dwkennedy/ballooning/README.md

# ballooning
all-in-one ballooning accessory (variometer, balloon cut-down, let down reel, tracking)
