dwkennedy/ballooning/documentation/README.md

[current version found here](https://docs.google.com/document/d/1-JqKBCpE__L-fvbFsnMLXefRrbQfZvNeuHzBmR8RMiw/edit?usp=sharing)
