dwkennedy/ballooning/hardware/schematic sketch.png

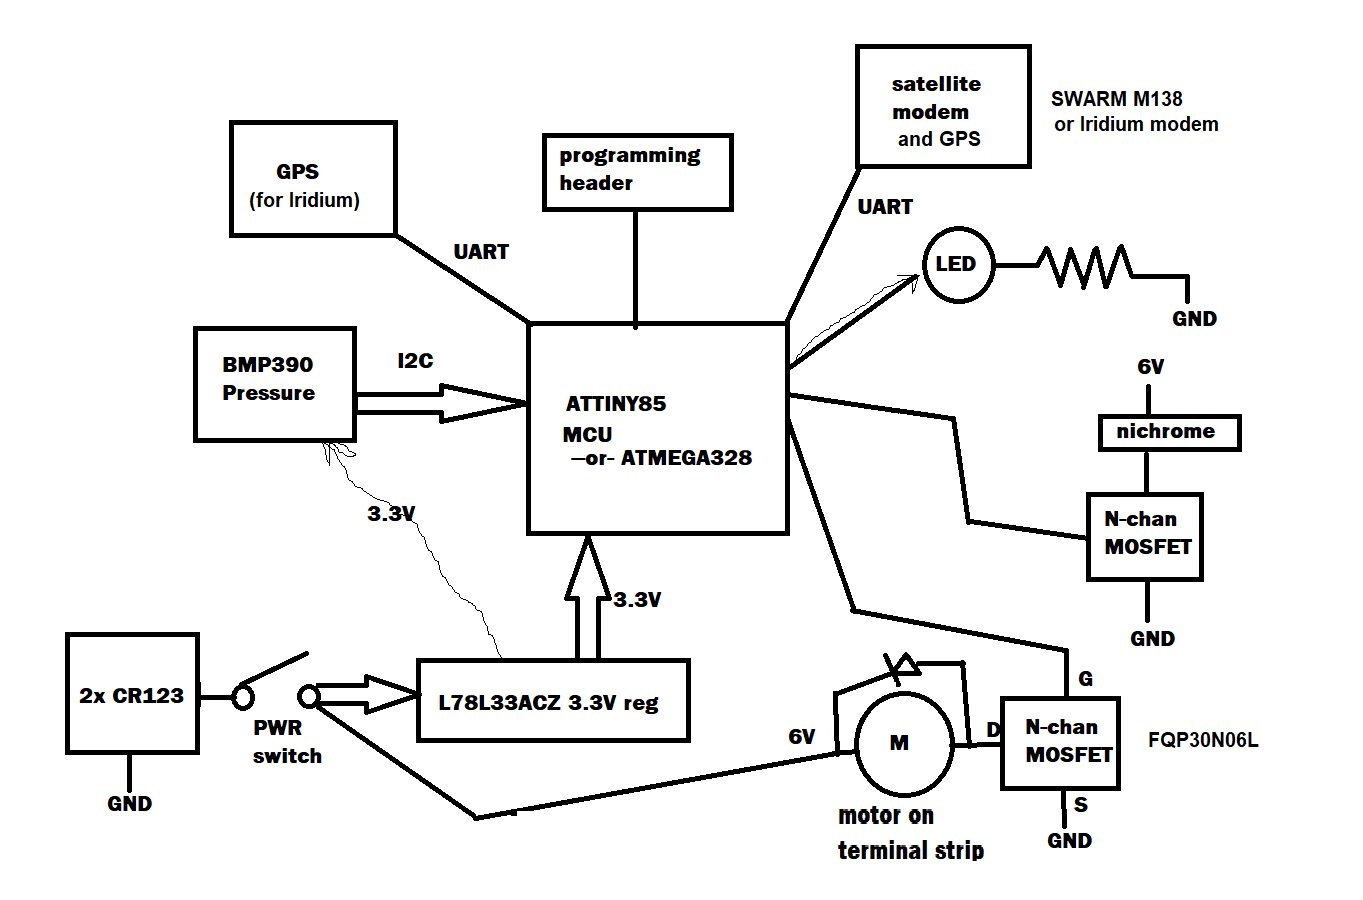
hardware/schematic sketch.png
