dwkennedy/ballooning/hardware/wombat_crop.jpg

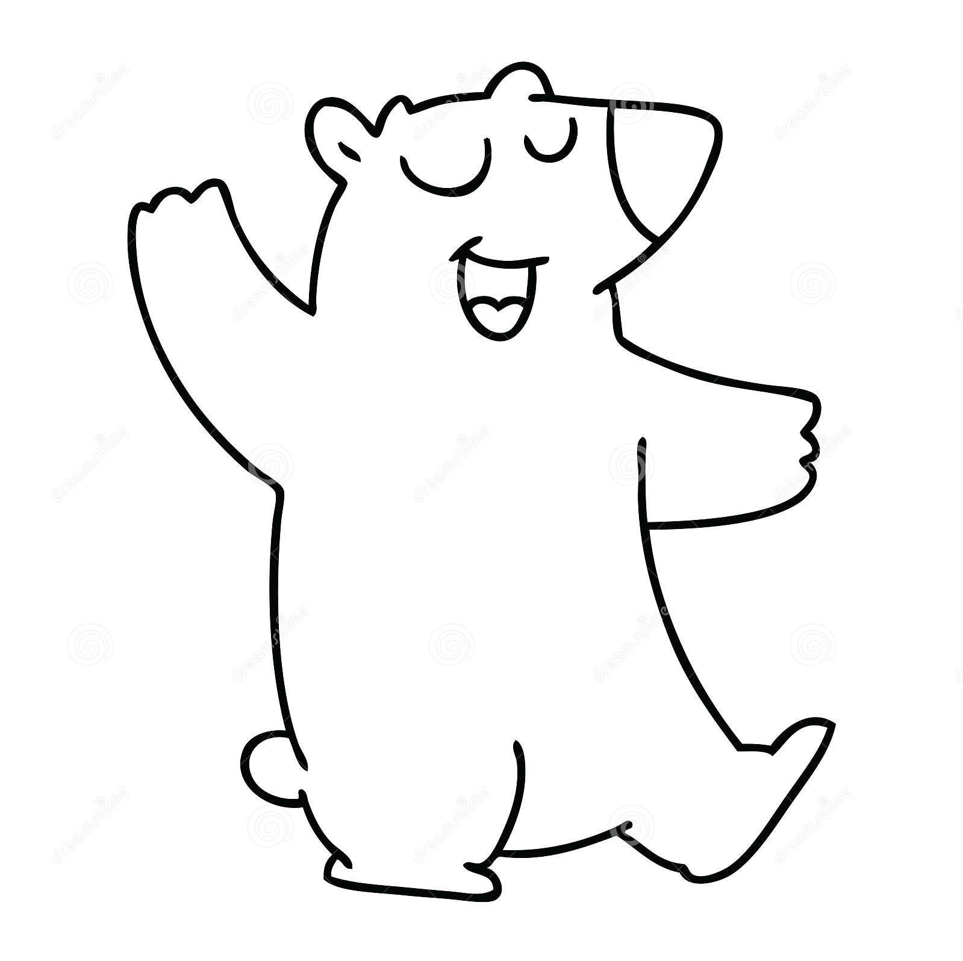
hardware/wombat_crop.jpg
