dwkennedy/ballooning/hardware/wombat_flip.jpg

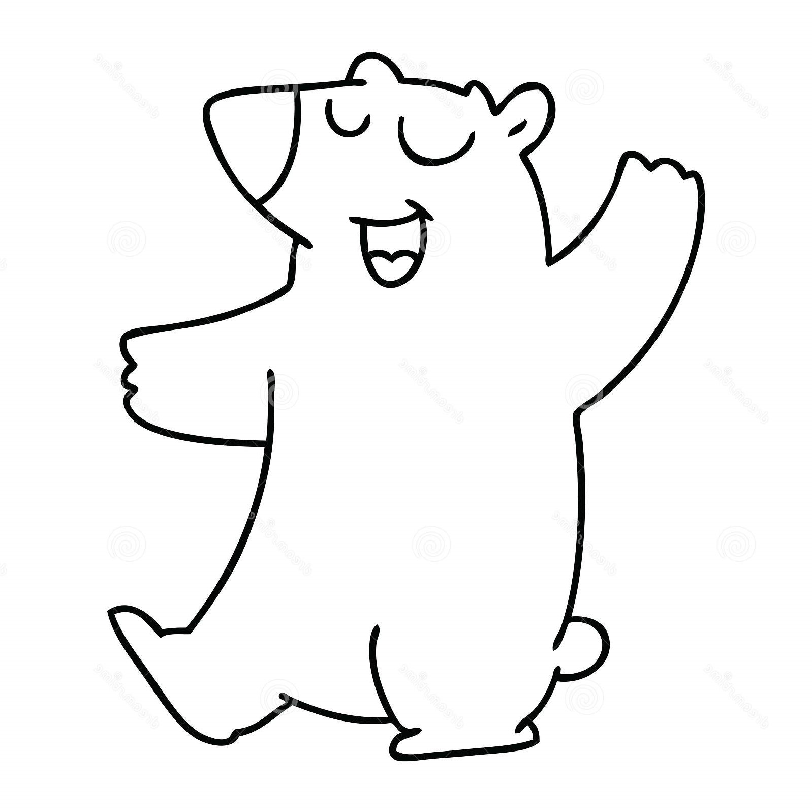
hardware/wombat_flip.jpg
