dwkennedy/ballooning/webapi/web application plumbing.png

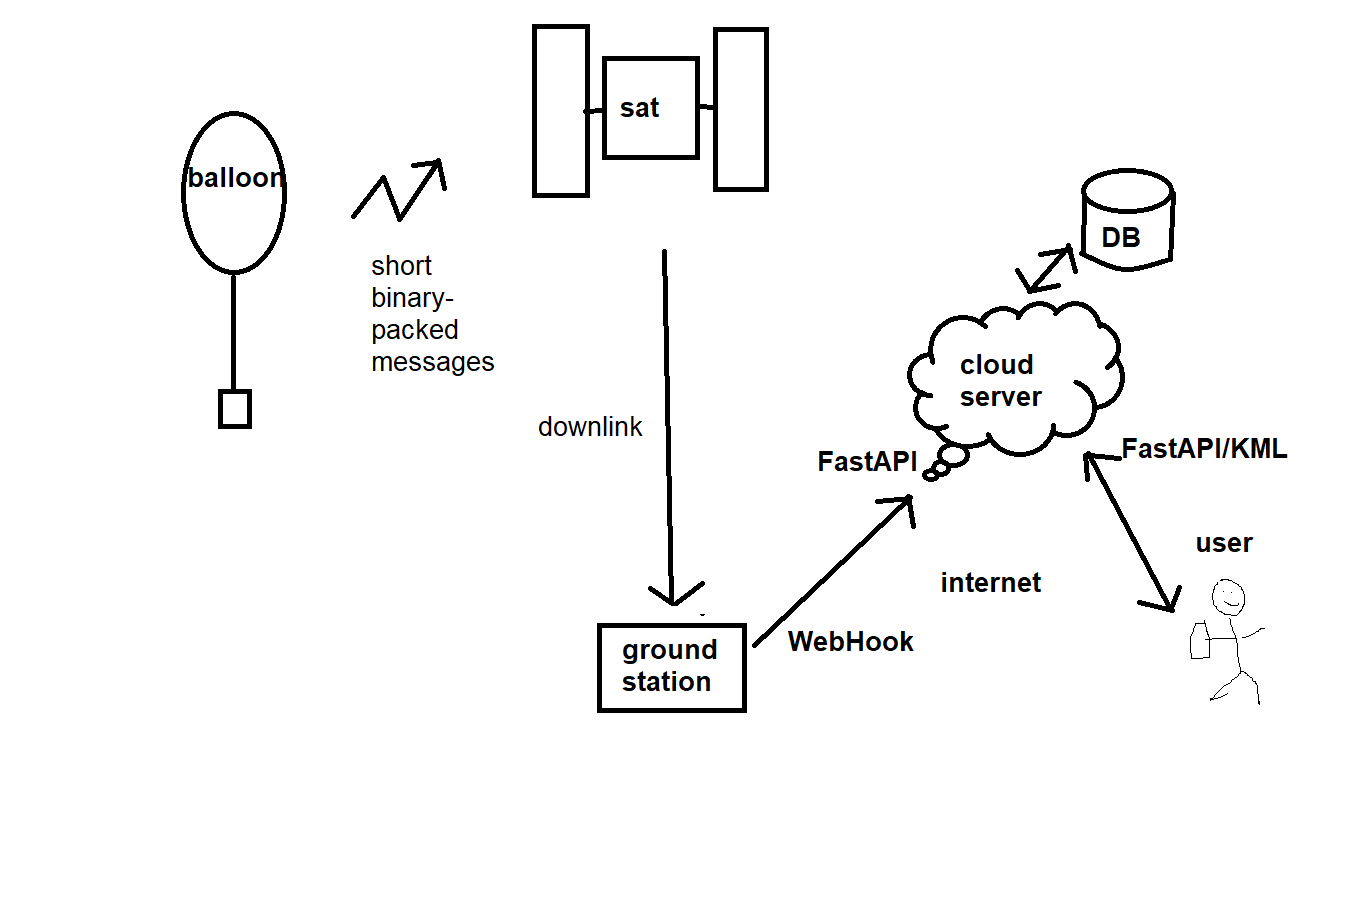
webapi/web application plumbing.png
