dwkennedy/ballooning/hardware/cut down control board BOM annotated.xlsx

Id | Designator | Package | Quantity | Designation | Supplier and ref | Column1 | _1
1 | R3,R2,R1 | R_Axial_DIN0204_L3.6mm_D1.6mm_P7.62mm_Horizontal | 3 | 10K | https://www.mouser.com/ProductDetail/YAGEO/CFR-12JT-52-10K | 0.1
2 | BT2,BT1,BT3 | BatteryHolder_Keystone_1051_1xCR123A | 3 | Battery_Cell | https://www.mouser.com/ProductDetail/Keystone-Electronics/1051?qs=wOxb8XianXhV6wGCGUD6gA%3D%3D | 1.84
3 | R8,R9 | R_Axial_DIN0204_L3.6mm_D1.6mm_P7.62mm_Horizontal | 2 | 1K | https://www.mouser.com/ProductDetail/YAGEO/CFR-12JT-52-1K?qs=uYSUDLr2H%2FJr7fImvVXADQ%3D%3D | 0.1
4 | J12 | PinHeader_2x03_P2.54mm_Vertical | 1 | Analog In | https://www.mouser.com/ProductDetail/Amphenol-FCI/10129381-906002BLF?qs=DXv0QSHKF4zSKXKyBbBVMw%3D%3D | 0.132
5 | ,,,,, |  | 6
6 | J13 | JST_XH_B2B-XH-A_1x02_P2.50mm_Vertical | 1 | EXT BATT | https://www.mouser.com/ProductDetail/Adafruit/4423?qs=xZ%2FP%252Ba9zWqZe%2FzQxvLxuOw%3D%3D | 0
7 | Q1,Q2 | TO-220-3_Horizontal_TabDown | 2 | FQP30N06L | https://www.mouser.com/ProductDetail/onsemi-Fairchild/FQP30N06L?qs=%252Beu4QTTVkDqugBwFplJ%252Bug%3D%3D | 1.84
8 | D2 | LED_D3.0mm | 1 | GRN | https://www.mouser.com/ProductDetail/Kingbright/WP424GDT?qs=UaZr%2F4HME3YaIwbSYqFJhw%3D%3D | 0.186
9 | J10 | Molex_PicoBlade_53047-1010_1x10_P1.25mm_Vertical | 1 | SAT(10 picoblade) | https://www.mouser.com/ProductDetail/Molex/53047-1010?qs=dvxwXVM4mZUfJg3FKCXbvw%3D%3D | 0.436
10 | Y1 | Crystal_HC49-4H_Vertical | 1 | 16MHz | https://www.mouser.com/ProductDetail/Citizen-FineDevice/HC-49-U-S16000000ABJB?qs=byeeYqUIh0M5kN9OYTo1Hw%3D%3D | 0.425
11 | R4 | R_Axial_DIN0204_L3.6mm_D1.6mm_P7.62mm_Horizontal | 1 | 100K | https://www.mouser.com/ProductDetail/YAGEO/CFR-12JT-52-100K?qs=LdthLRB3J3RCxaN6X2Lk%2Fw%3D%3D | 0.052
12 | U6 | TO-220-3_Horizontal_TabDown | 1 | L7805 | https://www.mouser.com/ProductDetail/STMicroelectronics/L7805ABV-DG?qs=WHlX%252B%252B9%2FRwBQWEBhrAcOaw%3D%3D | 0.805
13 | C11 | C_Axial_L5.1mm_D3.1mm_P7.50mm_Horizontal | 1 | 1uF | https://www.mouser.com/ProductDetail/KEMET/C440C105M5U5TA7200?qs=yWO8DBVyAvj3irko5Wpznw%3D%3D | 0.22
14 | R7,R6 | R_Axial_DIN0204_L3.6mm_D1.6mm_P7.62mm_Horizontal | 2 | 130 ohm | https://www.mouser.com/ProductDetail/YAGEO/CFR-25JB-52-130R | 0.026
15 | C8,C9,C4,C10,C5 | C_Axial_L5.1mm_D3.1mm_P7.50mm_Horizontal | 5 | 0.1uF | https://www.mouser.com/ProductDetail/Vishay-BC-Components/A104M15X7RF5TAA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 | 0.096
16 | J5 | PinHeader_1x06_P2.54mm_Vertical | 1 | SAT(PIN HDR) | https://www.mouser.com/ProductDetail/Amphenol-FCI/10129378-906001BLF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 | 0.132
17 | J11 | SolderJumper-3_P1.3mm_Bridged12_RoundedPad1.0x1.5mm | 1 | VGPS SELECT |  | 0
18
19 | J2 | JST_XH_B2B-XH-A_1x02_P2.50mm_Vertical | 1 | MOTOR | https://www.mouser.com/ProductDetail/Adafruit/4423?qs=xZ%2FP%252Ba9zWqZe%2FzQxvLxuOw%3D%3D | 0
20 | C7,C6 | C_Axial_L5.1mm_D3.1mm_P7.50mm_Horizontal | 2 | 0.33uF | https://www.mouser.com/ProductDetail/KYOCERA-AVX/SA115E334MAR?qs=PESGGumn0y%252BfK25TKgqhUA%3D%3D | 0.237
21 | J3 | PinHeader_2x03_P2.54mm_Vertical | 1 | ISP | https://www.mouser.com/ProductDetail/Amphenol-FCI/10129381-906002BLF?qs=DXv0QSHKF4zSKXKyBbBVMw%3D%3D | 0.132
22 | J14 | JST_XH_B2B-XH-A_1x02_P2.50mm_Vertical | 1 | D8 I/O | https://www.mouser.com/ProductDetail/Amphenol-FCI/68004-200HLF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 | 0.055
23 | R5 | R_Axial_DIN0204_L3.6mm_D1.6mm_P7.62mm_Horizontal | 1 | 33K | https://www.mouser.com/ProductDetail/YAGEO/CFR-12JT-52-33K?qs=uYSUDLr2H%2FIH9PHmEu75xQ%3D%3D | 0.029
24 | U2 | NXP_LGA-8_3x5mm_P1.25mm_H1.1mm | 1 | MPL3115A2 | https://www.mouser.com/ProductDetail/?qs=6ddF3R%2F6EV%2Fx8daKoNGetQ%3D%3D | 5.61
25 | D1 | LED_D3.0mm | 1 | RED | https://www.mouser.com/ProductDetail/Kingbright/WP424EDT?qs=58z0TXQGVSTTc%2FTzBOpAyQ%3D%3D | 0.186
26 | U1 | DIP-28_W7.62mm | 1 | ATmega328-P | https://www.mouser.com/ProductDetail/Microchip-Technology-Atmel/ATMEGA328P-PU?qs=K8BHR703ZXguOQv3sKbWcg%3D%3D | 2.87
27 | C12 | CP_Radial_D5.0mm_P2.00mm | 1 | 10uF | https://www.mouser.com/ProductDetail/Panasonic/ECA-1VM100?qs=F80sRR%252BEZdBj42PTfvMN%2FQ%3D%3D | 0.116
28 | J1 | JST_XH_B2B-XH-A_1x02_P2.50mm_Vertical | 1 | CUTTER | https://www.mouser.com/ProductDetail/Adafruit/4423?qs=xZ%2FP%252Ba9zWqZe%2FzQxvLxuOw%3D%3D | 0
29 | J7 | PinHeader_1x06_P2.54mm_Vertical | 1 | DBG TTL | https://www.mouser.com/ProductDetail/Amphenol-FCI/10129378-906001BLF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 | 0.132
30 | J6 | PinHeader_1x04_P2.54mm_Vertical | 1 | GPS(PIN HDR) | https://www.mouser.com/ProductDetail/Harwin/M50-3530442 | 0.159
31 | J9 | JST_SH_BM06B-SRSS-TB_1x06-1MP_P1.00mm_Vertical | 1 | GPS(JST SH) | https://www.mouser.com/ProductDetail/SparkFun/GPS-00579?qs=WyAARYrbSnYMUvZSImI8yA%3D%3D | 1.95
32 | SW1 | JST_XH_B2B-XH-A_1x02_P2.50mm_Vertical | 1 | SW_SPST | https://www.mouser.com/ProductDetail/Adafruit/4423?qs=xZ%2FP%252Ba9zWqZe%2FzQxvLxuOw%3D%3D | 0
33 | C2,C1 | C_Disc_D4.7mm_W2.5mm_P5.00mm | 2 | 22pF | https://www.mouser.com/ProductDetail/KYOCERA-AVX/SA102A220JAR?qs=5furm%2FeQHzRJtFTgVl96eA%3D%3D | 0.145
34 | U5 | TO-92_Inline | 1 | L78L33_TO92 | https://www.mouser.com/ProductDetail/STMicroelectronics/L78L33ABZ-AP?qs=7IaIRco65plqHZGvVBuyKw%3D%3D | 0.386 | L78L33ABZ-AP
 |  |  |  |  | total: | 18.397
