dwkennedy/ballooning/solidworks/bulkhead assembly small.SLDASM

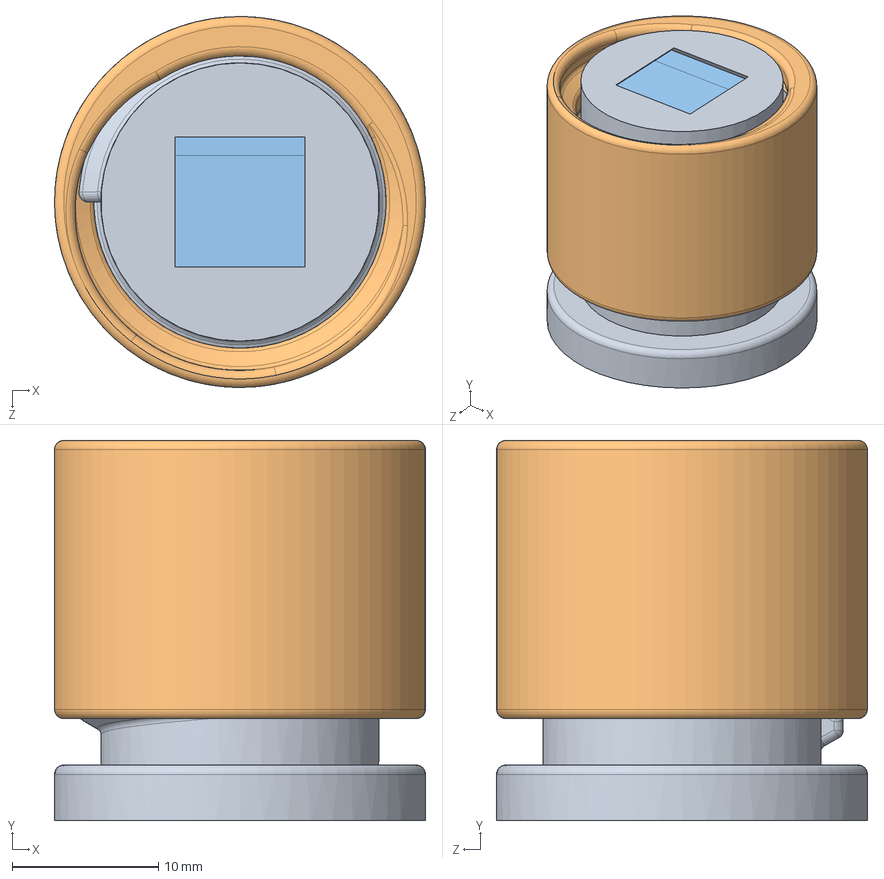
[picture p5: CAD file, 2023-01-06]
solidworks/bulkhead assembly small.SLDASM
25.4 x 26.0 x 25.4 mm
bulkhead body small
bulkhead nut small
93565K118_Super-Cushioning Polyethylene Foam Strip x 2
