dwkennedy/ballooning/solidworks/bulkhead assembly.SLDASM

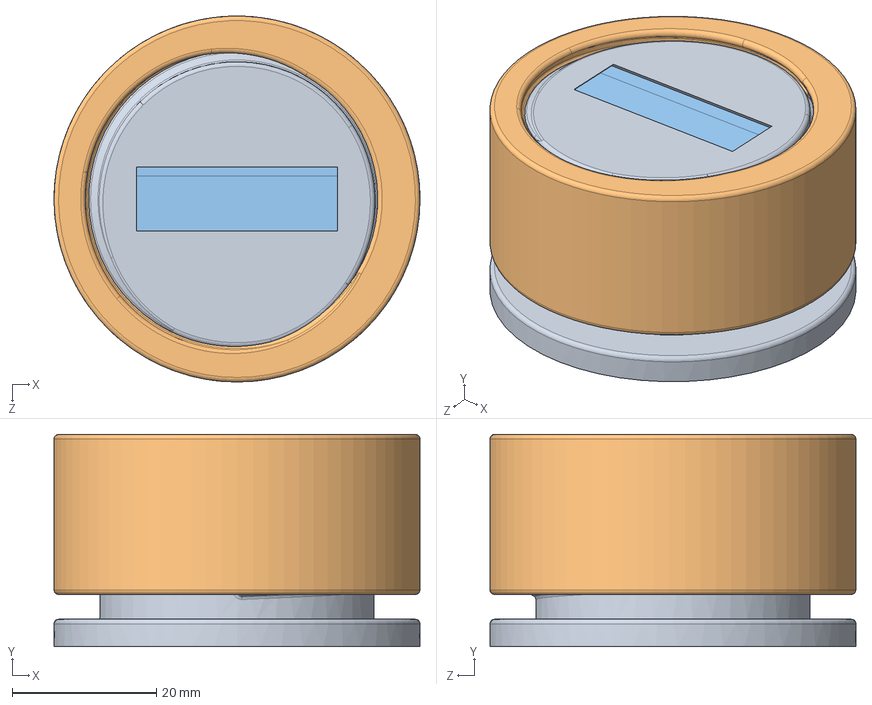
[picture p6: CAD file, 2022-11-28]
solidworks/bulkhead assembly.SLDASM
50.8 x 29.5 x 50.8 mm
bulkhead body
bulkhead nut
8694K141_Light Duty Blended EPDM Foam Strip x 2
