dwkennedy/ballooning/solidworks/phoenix_2pos_terminal_blk_pxc_1840366_05_MC-1-5-2-ST-3-5_3D.SLDASM

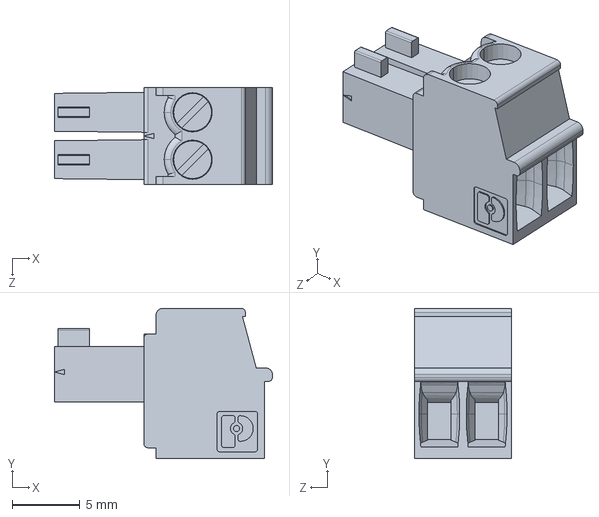
[picture p7: CAD file, 2022-11-09]
solidworks/phoenix_2pos_terminal_blk_pxc_1840366_05_MC-1-5-2-ST-3-5_3D.SLDASM
16.1 x 11.1 x 7.20 mm
