dwkennedy/ballooning/solidworks/phoenix_2pos_horiz_pxc_1844210_05_MC-1-5-2-G-3-5_3D.SLDASM

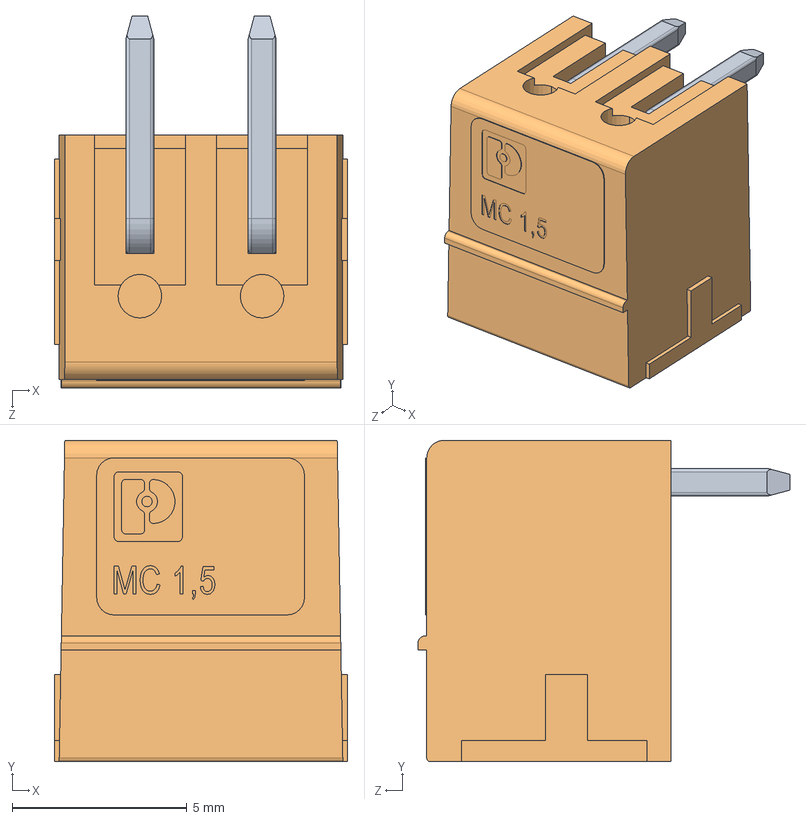
[picture p8: CAD file, 2022-10-21]
solidworks/phoenix_2pos_horiz_pxc_1844210_05_MC-1-5-2-G-3-5_3D.SLDASM
8.40 x 9.20 x 10.6 mm
LP_MC_1_5_G_3_5.6.stp x 2
AT_MC_1_5_G_3_5.stp
