dwkennedy/ballooning/solidworks/cut down control board.SLDASM

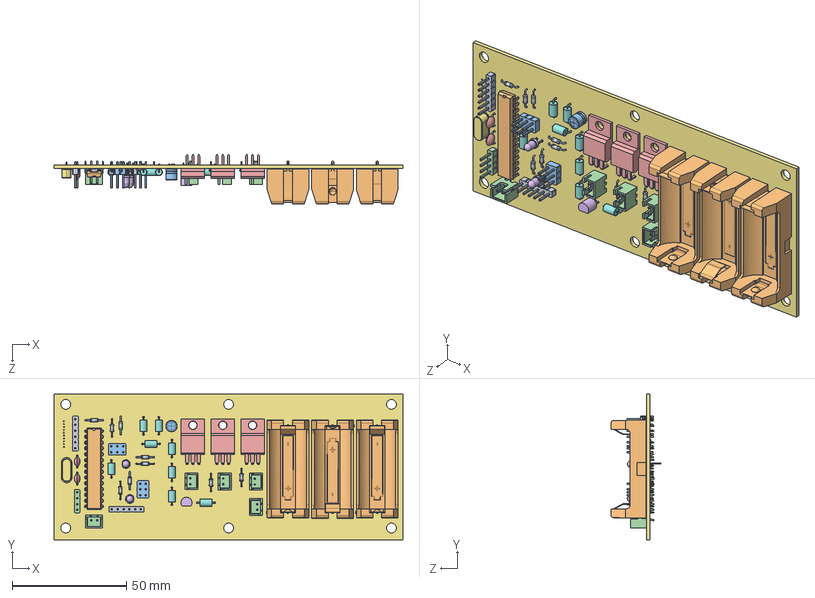
[picture p9: CAD file, 2022-10-21]
solidworks/cut down control board.SLDASM
152.4 x 63.7 x 21.8 mm
SOLID.step x 9
COMPOUND.step x 3
SOLID-0.step x 2
SOLID-1.step x 5
SOLID-2.step x 3
SOLID-3.step x 2
SOLID-4.step
SOLID-5.step x 8
SOLID-6.step x 2
SOLID-7.step
SOLID-8.step
SOLID-9.step
SOLID-10.step x 2
SOLID-11.step
cut down control board PCB.step
