dwkennedy/ballooning/solidworks/phoenix_2pos_vertical_pxc_1843606_03_MCV-1-5-2-G-3-5_3D.SLDASM

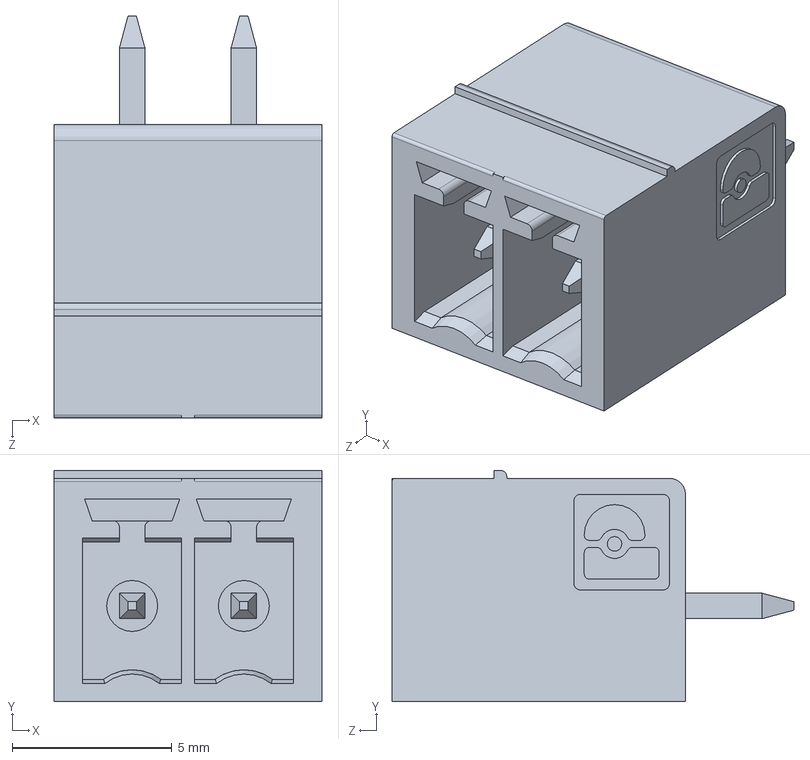
[picture p10: CAD file, 2022-10-21]
solidworks/phoenix_2pos_vertical_pxc_1843606_03_MCV-1-5-2-G-3-5_3D.SLDASM
8.40 x 7.25 x 12.6 mm
