dwkennedy/ballooning/solidworks/motor assembly.SLDASM

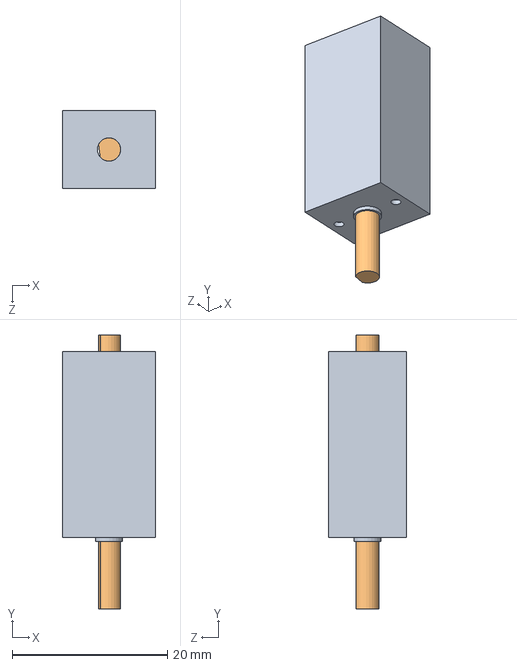
[picture p11: CAD file, 2022-09-23]
solidworks/motor assembly.SLDASM
12.0 x 35.3 x 10.0 mm
motor body
motor shaft
