dwkennedy/ballooning/solidworks/master assembly.SLDASM

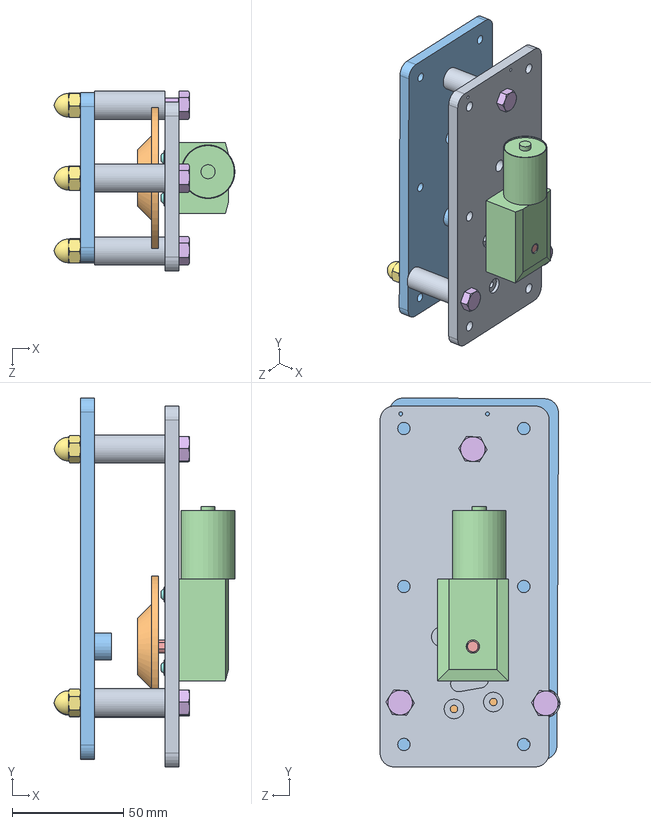
[picture p12: CAD file, 2022-09-23]
solidworks/master assembly.SLDASM
81.4 x 166.1 x 81.0 mm
right receiver plate
spool flange
left receiver plate
big motor body
D-profile rotary shaft 6mm
91970A550_Black Nylon Hex Head Screws x 3
90003A029_Nylon 6 6 Plastic Cap Nut x 3
97654A675_18-8 Stainless Steel Flanged Button Head Screw x 4
nylon spacer x 3
