dwkennedy/ballooning/solidworks/test.SLDASM

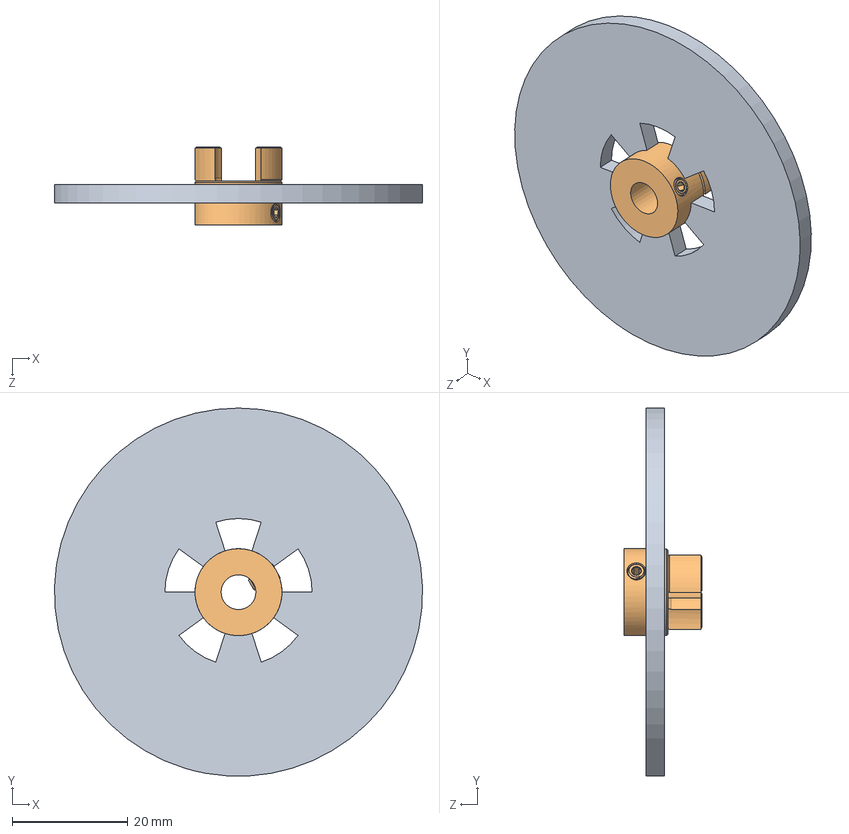
[picture p13: CAD file, 2022-09-23]
solidworks/test.SLDASM
63.5 x 63.4 x 13.5 mm
spool flange
9939T314_Vibrate-Damping Precision Flexible Shaft Coupling
