dwkennedy/ballooning/hardware/keystone-PN1051.STEP

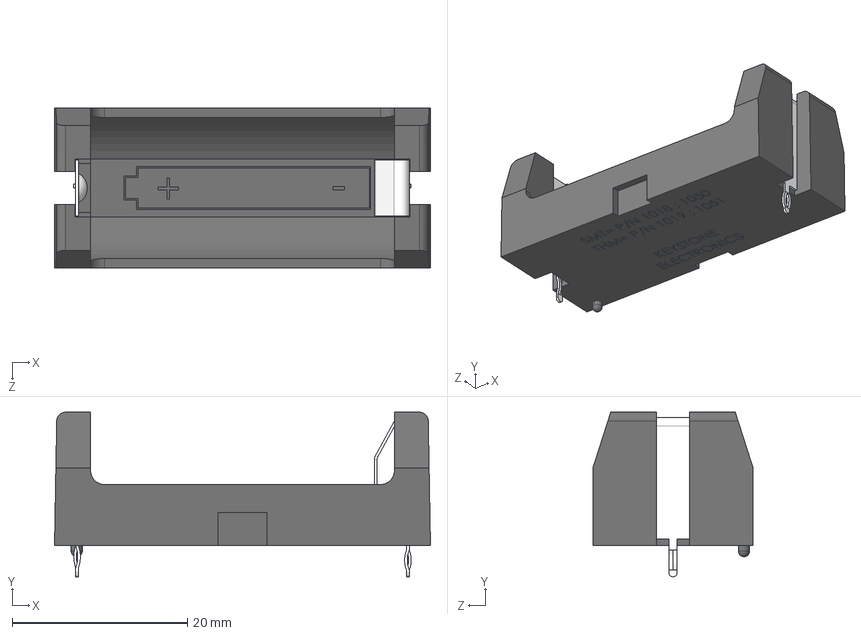
[picture p14: CAD file, 2022-10-13]
hardware/keystone-PN1051.STEP
42.9 x 18.8 x 18.3 mm
