dwkennedy/ballooning/solidworks/637226 Assembly/big motor body.SLDPRT

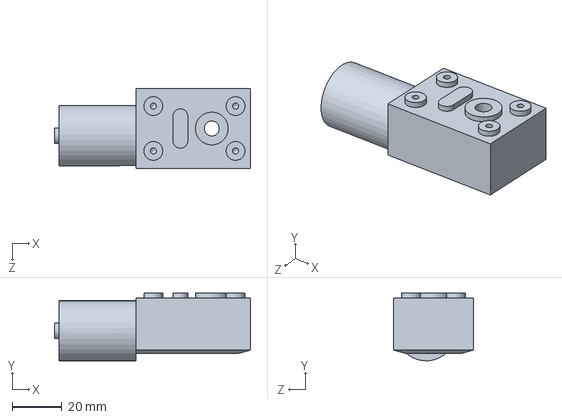
[picture p15: CAD file, 2022-10-29]
solidworks/637226 Assembly/big motor body.SLDPRT
78.7 x 27.2 x 32.0 mm
