dwkennedy/ballooning/solidworks/spool axle LARGE.SLDPRT

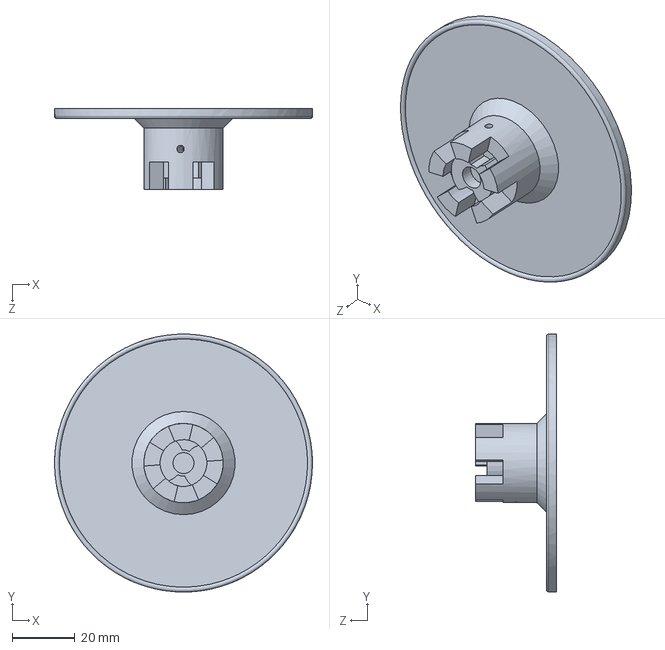
[picture p16: CAD file, 2023-01-19]
solidworks/spool axle LARGE.SLDPRT
82.5 x 82.5 x 26.0 mm
