dwkennedy/ballooning/solidworks/STL/bulkhead small 040mm.3mf

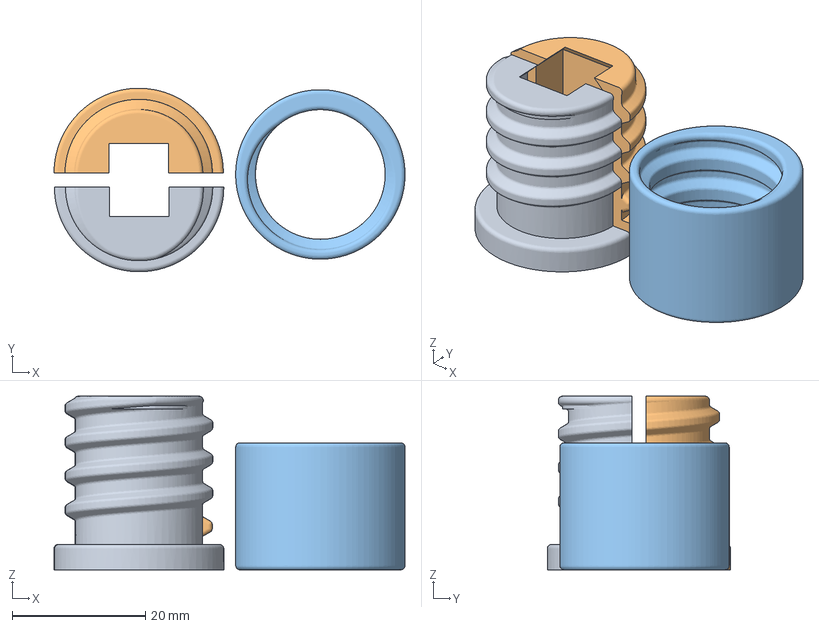
[picture p17: CAD file, 2022-11-29]
solidworks/STL/bulkhead small 040mm.3mf
52.6 x 27.5 x 26.0 mm
bulkhead body small BOTTOM.STL
bulkhead body small TOP.STL
bulkhead nut small.STL
