dwkennedy/ballooning/solidworks/enclosure brace TOP.SLDPRT

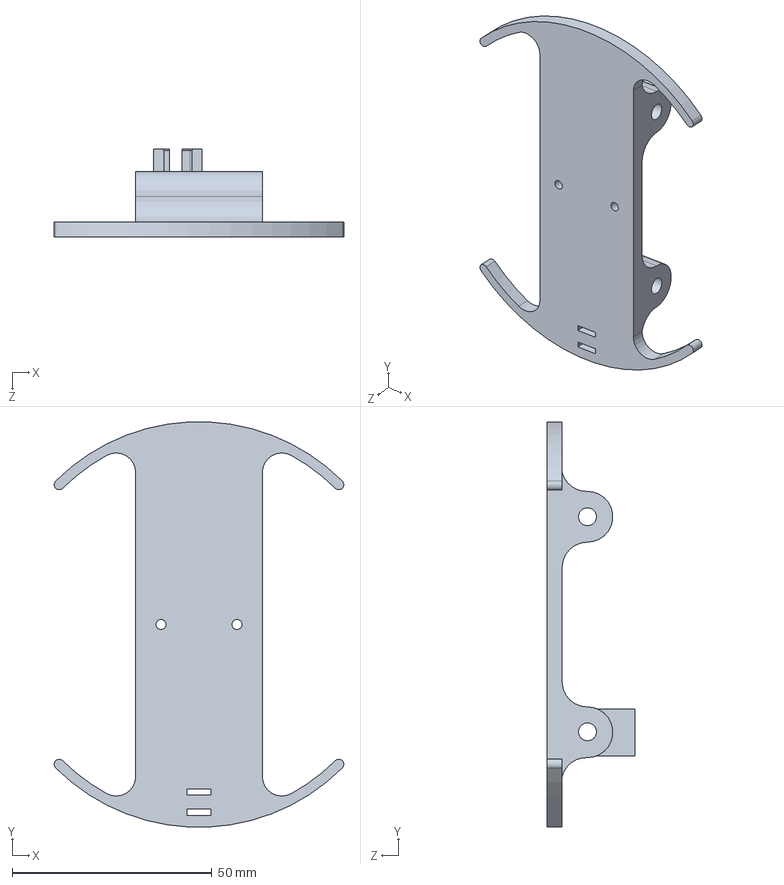
[picture p18: CAD file, 2023-01-17]
solidworks/enclosure brace TOP.SLDPRT
72.6 x 101.5 x 22.1 mm
