dwkennedy/ballooning/solidworks/STL/bulkhead body small TOP.STL

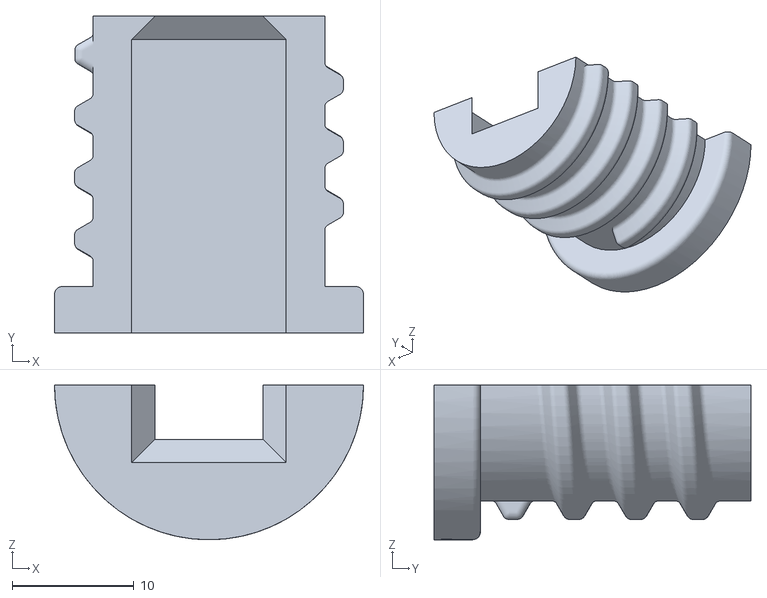
[picture p19: CAD file, 2022-11-29]
solidworks/STL/bulkhead body small TOP.STL
25.4 x 26.0 x 12.7
