dwkennedy/ballooning/solidworks/enclosure brace BOTTOM 2 hole.SLDPRT

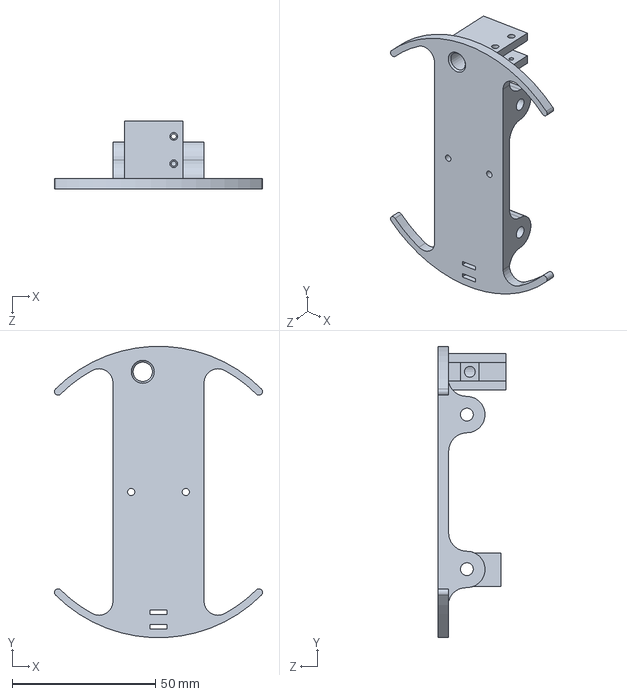
[picture p21: CAD file, 2023-01-17]
solidworks/enclosure brace BOTTOM 2 hole.SLDPRT
72.6 x 101.5 x 23.9 mm
