dwkennedy/ballooning/solidworks/STL/bulkhead body BOTTOM.STL

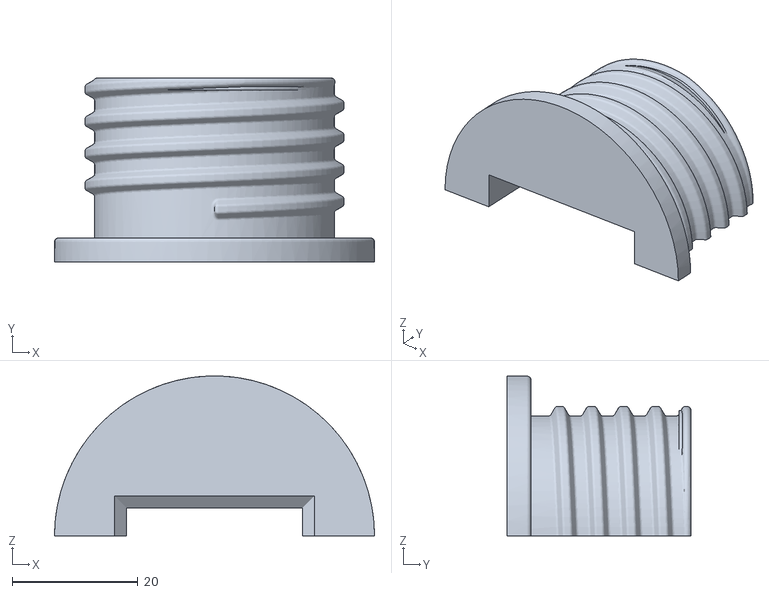
[picture p22: CAD file, 2022-11-28]
solidworks/STL/bulkhead body BOTTOM.STL
50.8 x 29.2 x 25.4
