dwkennedy/ballooning/solidworks/spool flange LARGE.SLDPRT

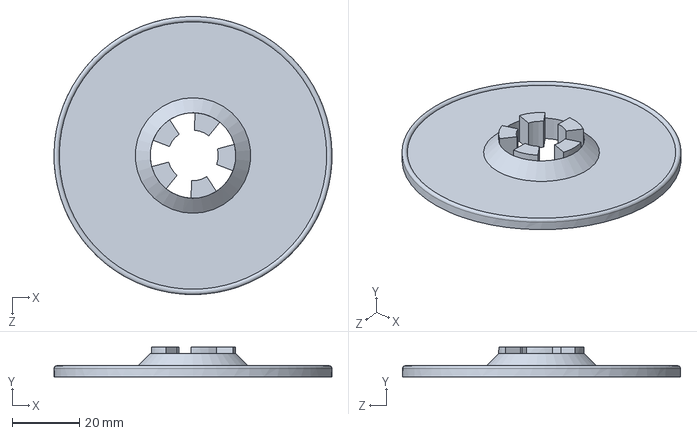
[picture p23: CAD file, 2023-01-17]
solidworks/spool flange LARGE.SLDPRT
82.5 x 8.89 x 82.5 mm
