dwkennedy/ballooning/solidworks/STL/bulkhead.3mf

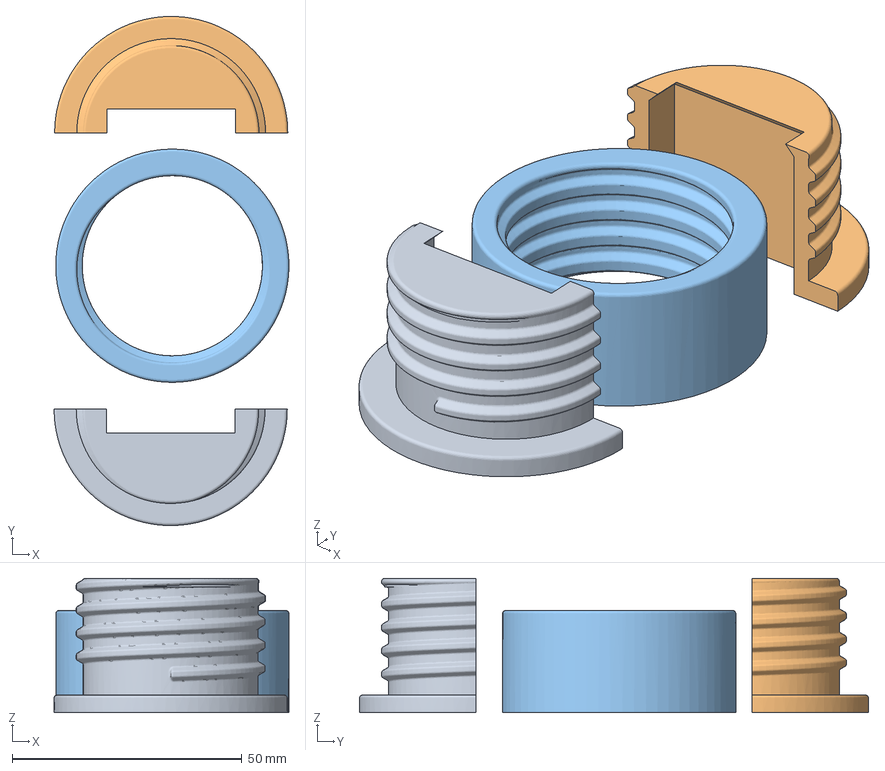
[picture p24: CAD file, 2022-11-28]
solidworks/STL/bulkhead.3mf
51.2 x 110.9 x 29.2 mm
bulkhead body BOTTOM.STL
bulkhead body TOP.STL
bulkhead nut.STL
