dwkennedy/ballooning/solidworks/STL/spool.STL

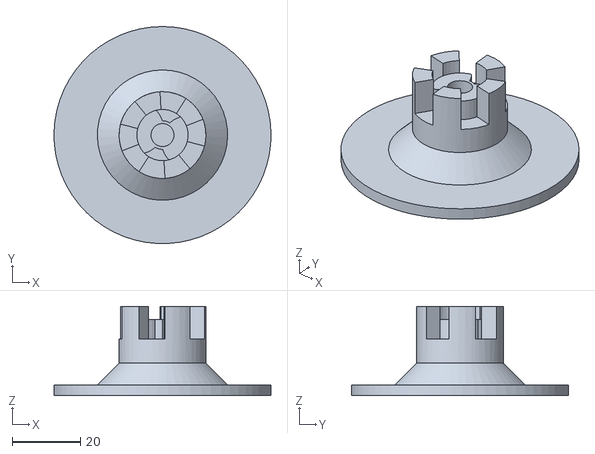
[picture p25: CAD file, 2022-11-05]
solidworks/STL/spool.STL
63.5 x 63.5 x 26.2
