dwkennedy/ballooning/solidworks/left receiver plate.SLDPRT

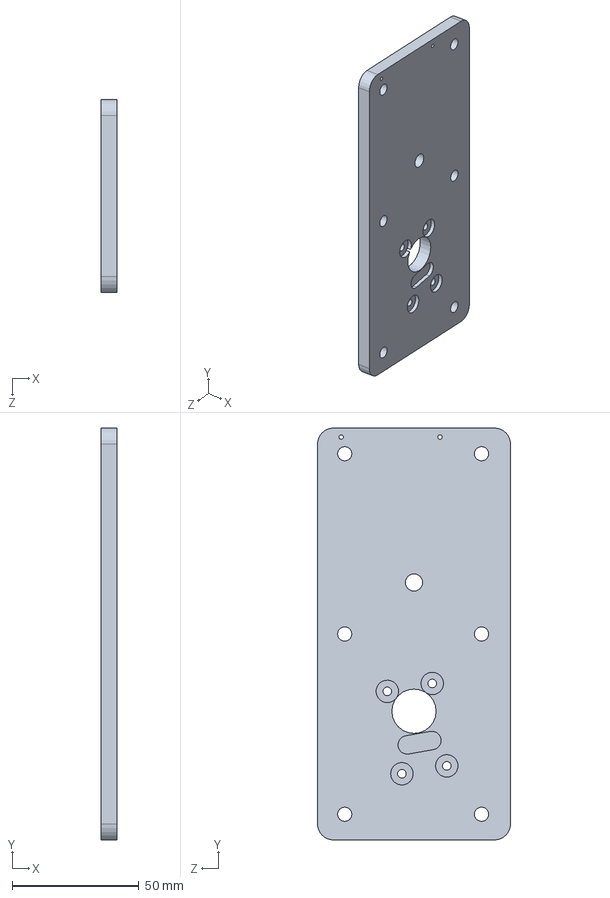
[picture p26: CAD file, 2023-01-06]
solidworks/left receiver plate.SLDPRT
6.35 x 162.6 x 76.2 mm
