dwkennedy/ballooning/solidworks/bulkhead body.SLDPRT

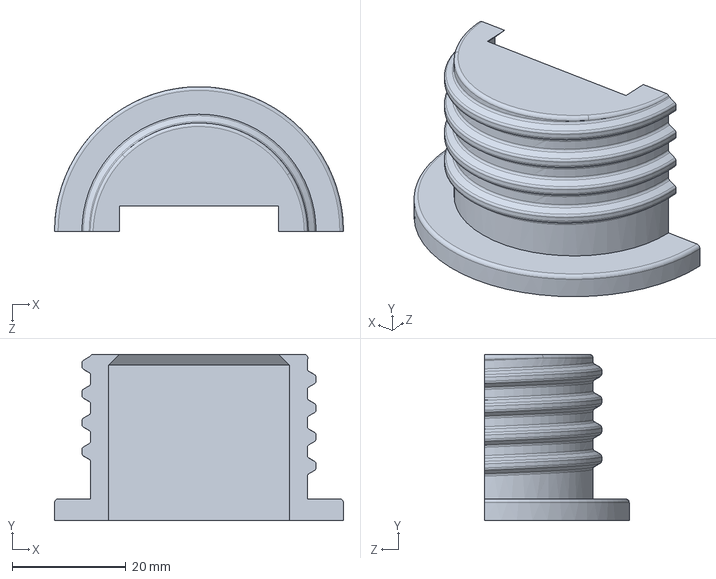
[picture p27: CAD file, 2022-11-28]
solidworks/bulkhead body.SLDPRT
50.8 x 29.2 x 25.4 mm
