dwkennedy/ballooning/solidworks/spool axle.SLDPRT

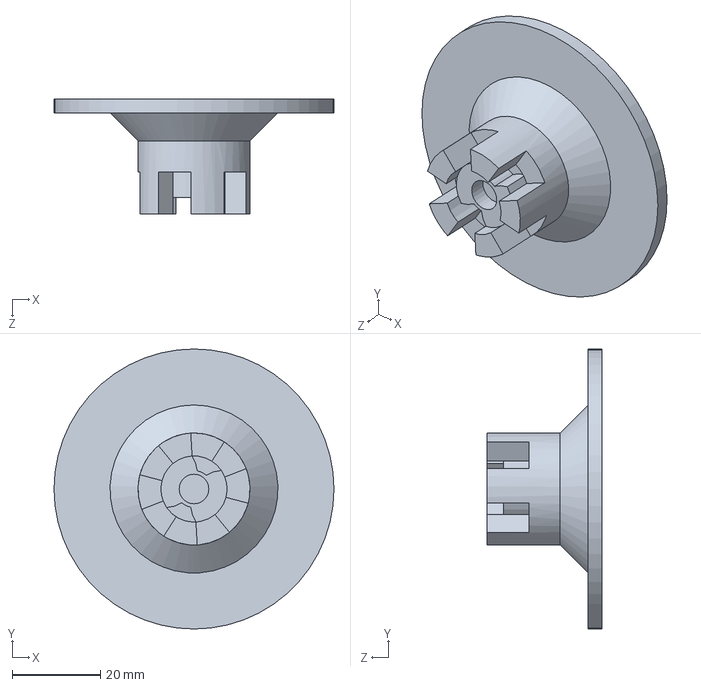
[picture p28: CAD file, 2022-11-28]
solidworks/spool axle.SLDPRT
63.5 x 63.5 x 26.2 mm
