dwkennedy/ballooning/solidworks/monofilament pigtail.SLDPRT

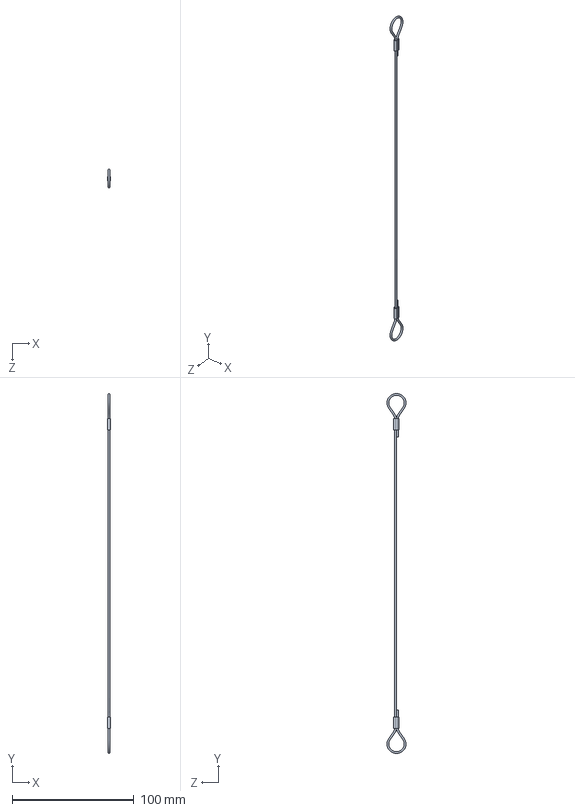
[picture p29: CAD file, 2022-11-09]
solidworks/monofilament pigtail.SLDPRT
2.84 x 295.1 x 15.8 mm
