dwkennedy/ballooning/solidworks/nichrome_3,5mm.SLDPRT

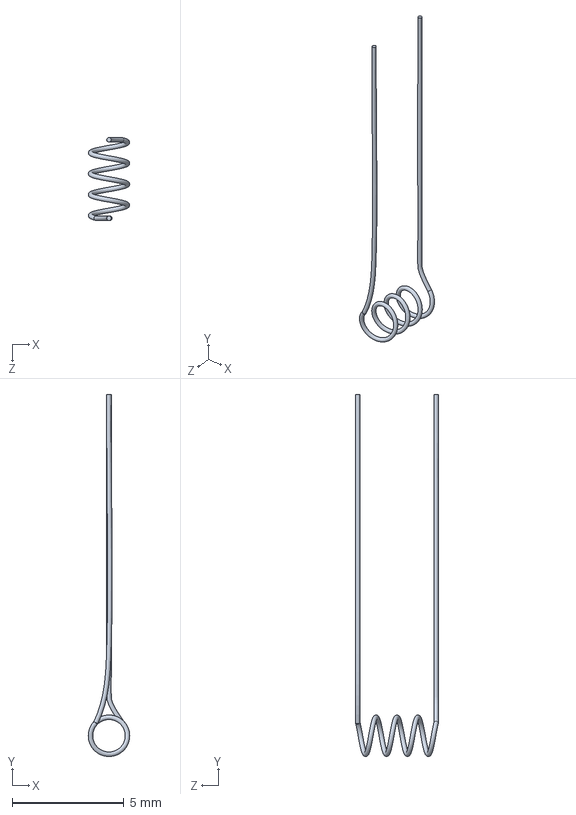
[picture p30: CAD file, 2022-11-09]
solidworks/nichrome_3,5mm.SLDPRT
1.85 x 16.2 x 3.70 mm
