dwkennedy/ballooning/solidworks/foam spacer.SLDPRT

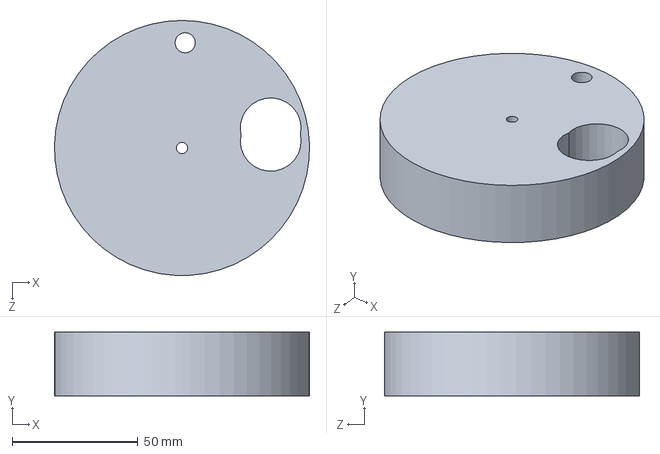
[picture p31: CAD file, 2022-11-03]
solidworks/foam spacer.SLDPRT
101.6 x 25.4 x 101.6 mm
