dwkennedy/ballooning/solidworks/Copper tape.SLDPRT

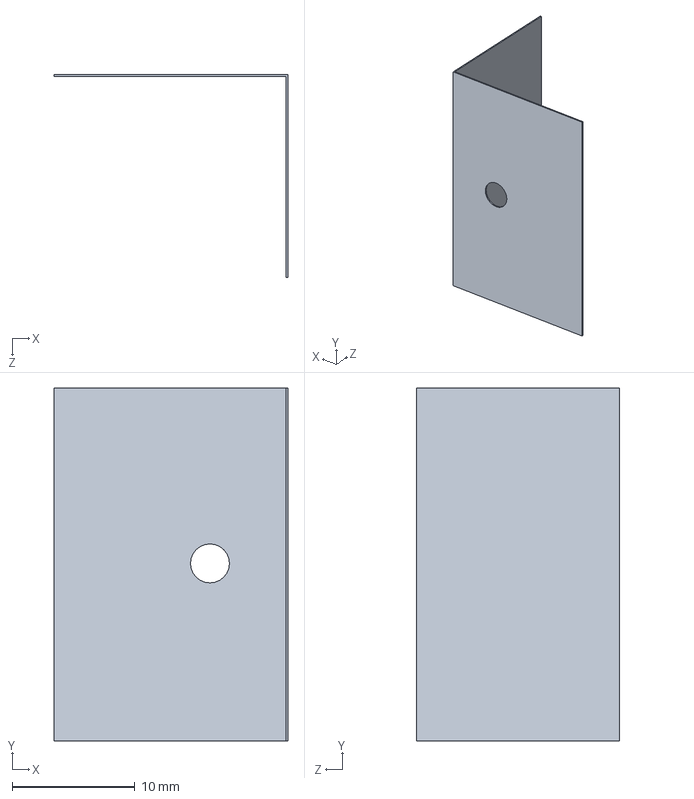
[picture p32: CAD file, 2022-11-03]
solidworks/Copper tape.SLDPRT
19.1 x 28.8 x 16.5 mm
