dwkennedy/ballooning/solidworks/plastic tube.SLDPRT

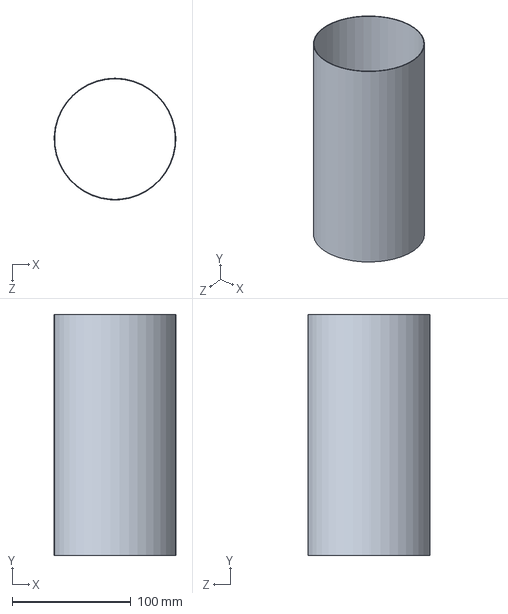
[picture p33: CAD file, 2022-10-29]
solidworks/plastic tube.SLDPRT
102.7 x 203.2 x 102.6 mm
