dwkennedy/ballooning/solidworks/nylon spacer.SLDPRT

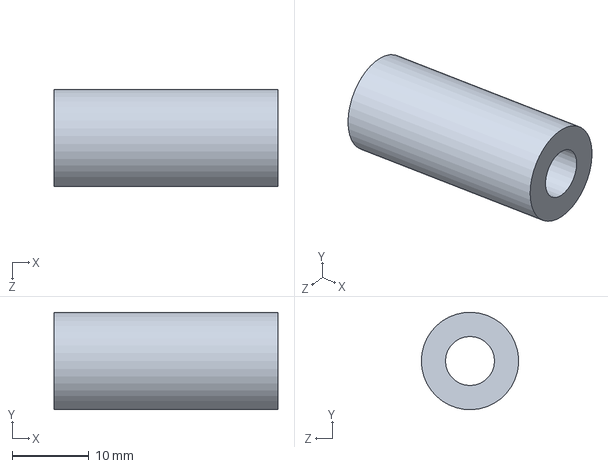
[picture p34: CAD file, 2022-10-29]
solidworks/nylon spacer.SLDPRT
29.2 x 12.7 x 12.7 mm
