dwkennedy/ballooning/solidworks/monofilament.SLDPRT

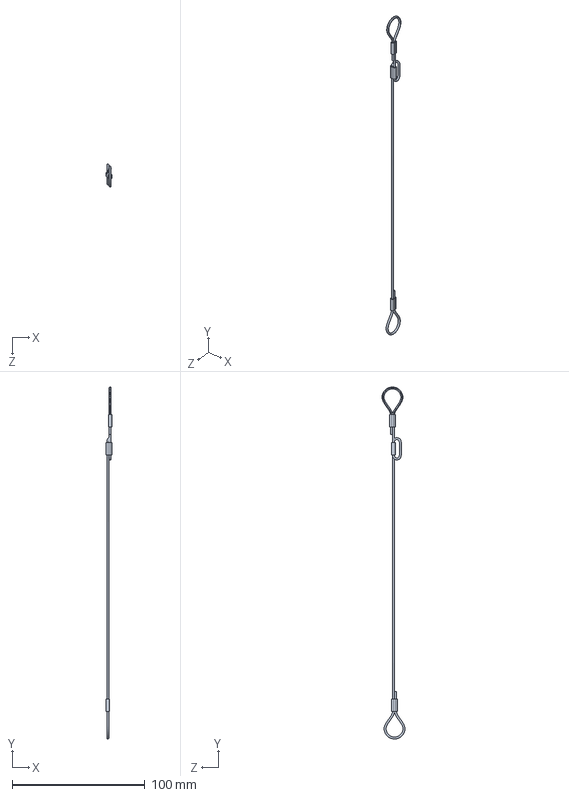
[picture p35: CAD file, 2022-10-29]
solidworks/monofilament.SLDPRT
4.62 x 265.3 x 17.3 mm
