dwkennedy/ballooning/solidworks/right receiver plate.SLDPRT

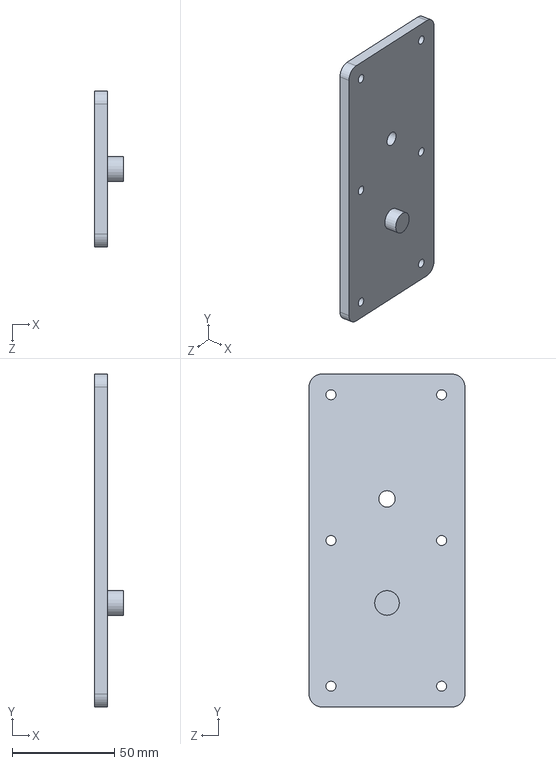
[picture p36: CAD file, 2022-10-28]
solidworks/right receiver plate.SLDPRT
14.0 x 162.6 x 76.2 mm
