dwkennedy/ballooning/solidworks/rigging pog 2.SLDPRT

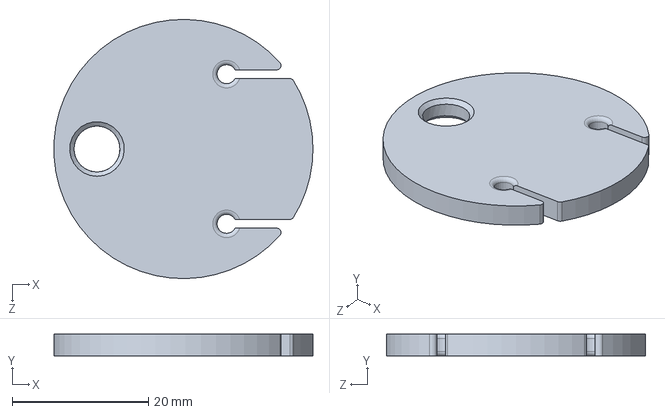
[picture p37: CAD file, 2022-10-28]
solidworks/rigging pog 2.SLDPRT
38.1 x 3.17 x 38.1 mm
