dwkennedy/ballooning/solidworks/spacer_rockblock_for_3d.SLDPRT

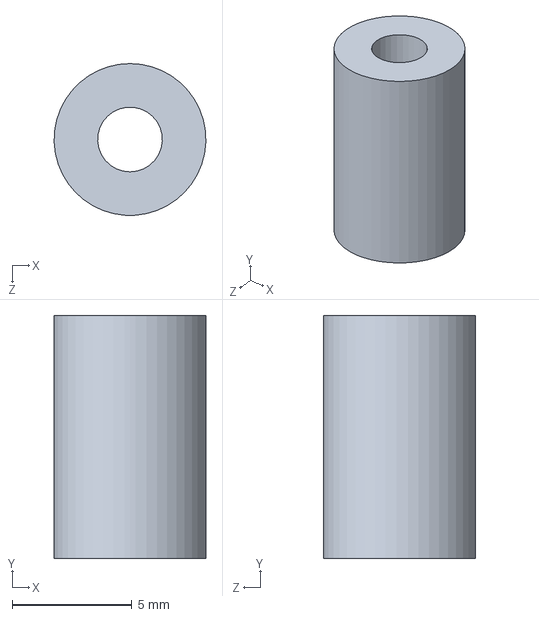
[picture p38: CAD file, 2022-10-28]
solidworks/spacer_rockblock_for_3d.SLDPRT
6.35 x 10.2 x 6.35 mm
