dwkennedy/ballooning/solidworks/enclosure_with_dome.SLDPRT

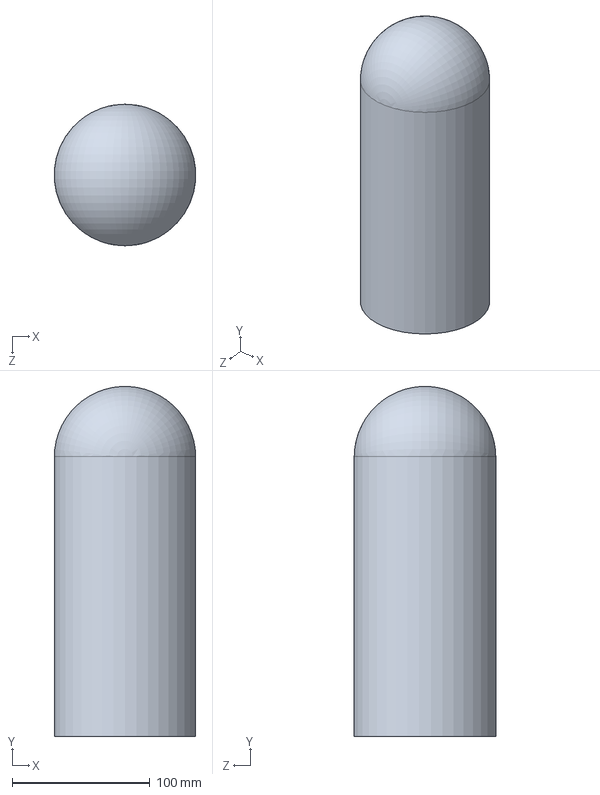
[picture p39: CAD file, 2022-10-21]
solidworks/enclosure_with_dome.SLDPRT
102.4 x 253.8 x 102.7 mm
