dwkennedy/ballooning/solidworks/enclosure brace TOWER.SLDPRT

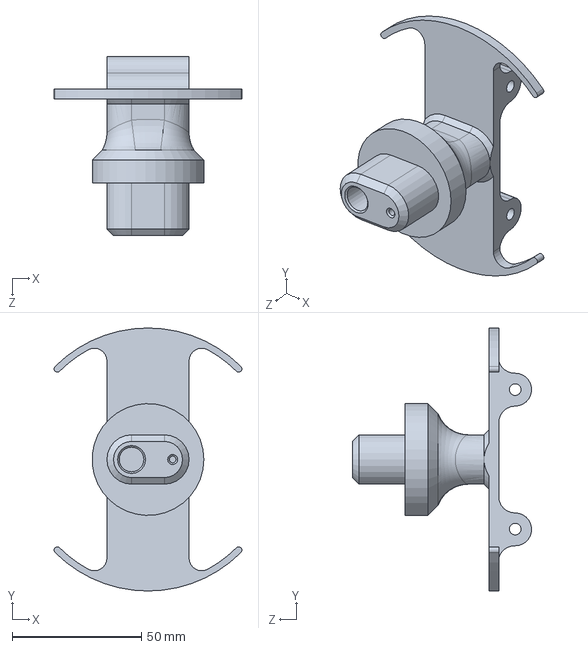
[picture p40: CAD file, 2022-10-21]
solidworks/enclosure brace TOWER.SLDPRT
72.6 x 101.6 x 69.2 mm
