dwkennedy/ballooning/solidworks/MBZ1_xxxC02X02.stp

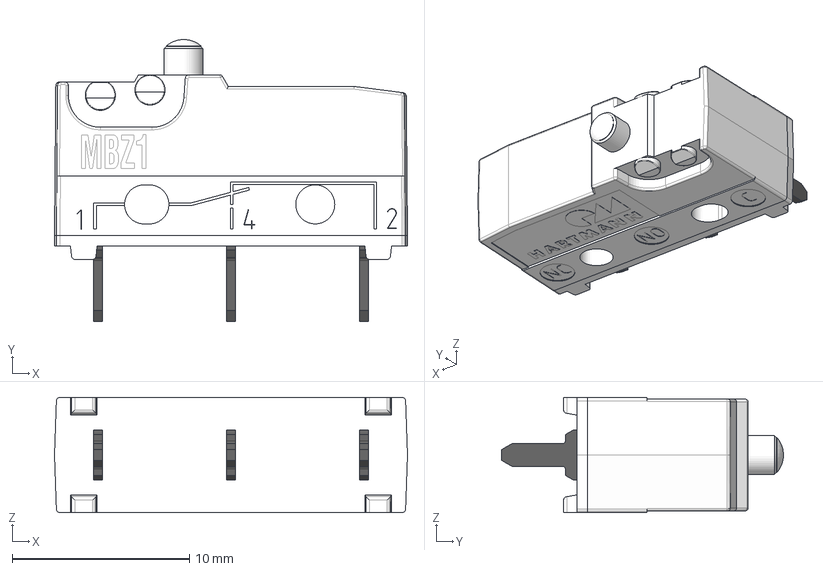
[picture p41: CAD file, 2022-10-21]
solidworks/MBZ1_xxxC02X02.stp
19.9 x 15.9 x 6.50 mm
D_Kappe_MBZ1
D_Sockel_m_Abstandshalter_MBZ1
D_Betätiger mit Kugelform_MBZ1
D_Leiterplattenanschluss_0.5x1.3_links_MBZ1
D_Leiterplattenanschluss_0.5x1.3_mitte_MBZ1
D_Leiterplattenanschluss_0.5x1.3_rechts_MBZ1
