dwkennedy/ballooning/solidworks/switch holder.SLDPRT

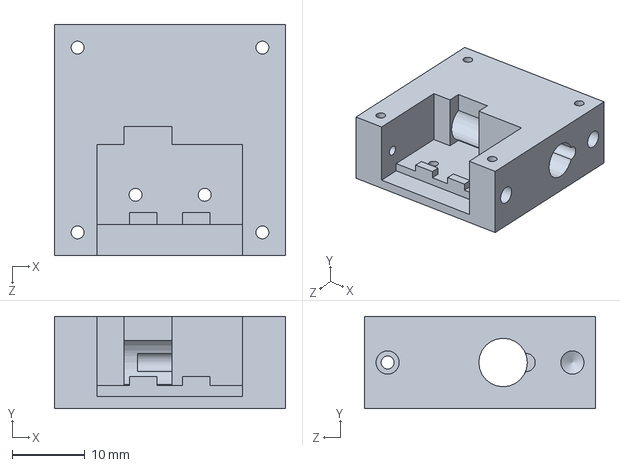
[picture p42: CAD file, 2022-10-21]
solidworks/switch holder.SLDPRT
31.8 x 12.7 x 31.8 mm
