dwkennedy/ballooning/solidworks/Reel eyelet.SLDPRT

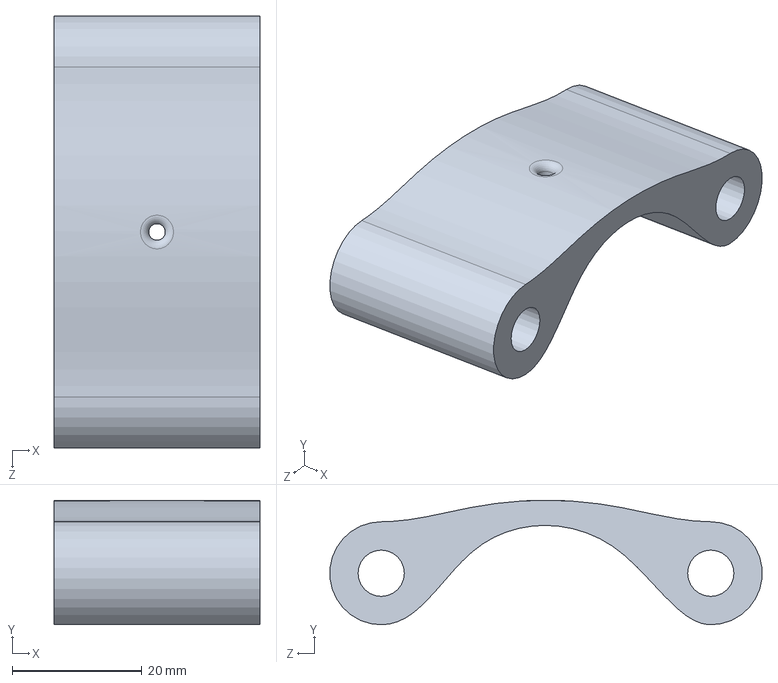
[picture p43: CAD file, 2022-10-21]
solidworks/Reel eyelet.SLDPRT
31.8 x 19.2 x 66.6 mm
