dwkennedy/ballooning/solidworks/enclosure.SLDPRT

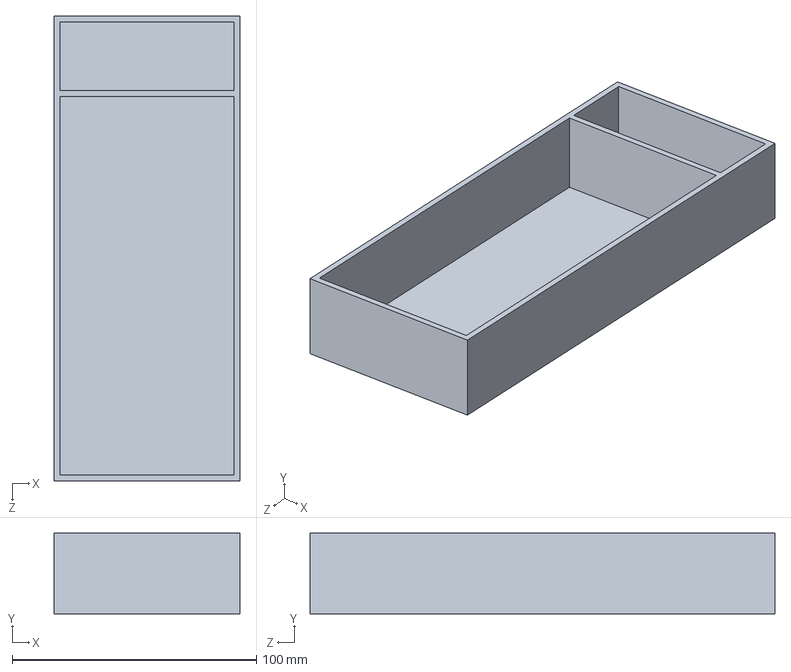
[picture p44: CAD file, 2022-10-21]
solidworks/enclosure.SLDPRT
76.2 x 33.0 x 190.5 mm
