dwkennedy/ballooning/solidworks/pxc_1757019_07_MSTB-2-5-2-ST-5-08_3D.stp

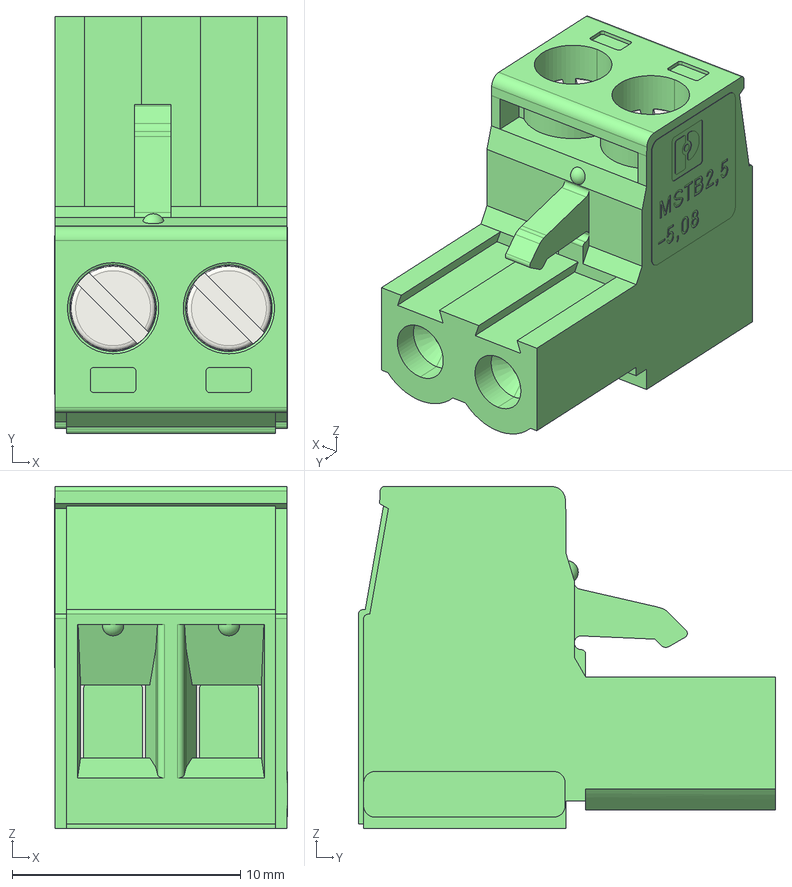
[picture p45: CAD file, 2022-10-21]
solidworks/pxc_1757019_07_MSTB-2-5-2-ST-5-08_3D.stp
10.2 x 18.3 x 15.0 mm
MSTB-2.5-Clamp-sleeve x 2
MSTB-2.5-GEH
