dwkennedy/ballooning/solidworks/pxc_1843606_03_MCV-1-5-2-G-3-5_3D.stp

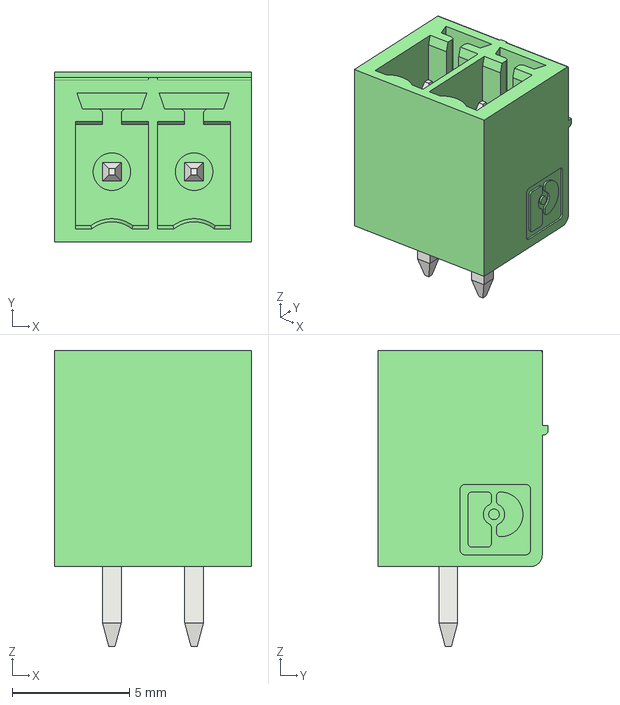
[picture p46: CAD file, 2022-10-21]
solidworks/pxc_1843606_03_MCV-1-5-2-G-3-5_3D.stp
8.40 x 7.25 x 12.6 mm
