dwkennedy/ballooning/solidworks/ultimate GPS.SLDPRT

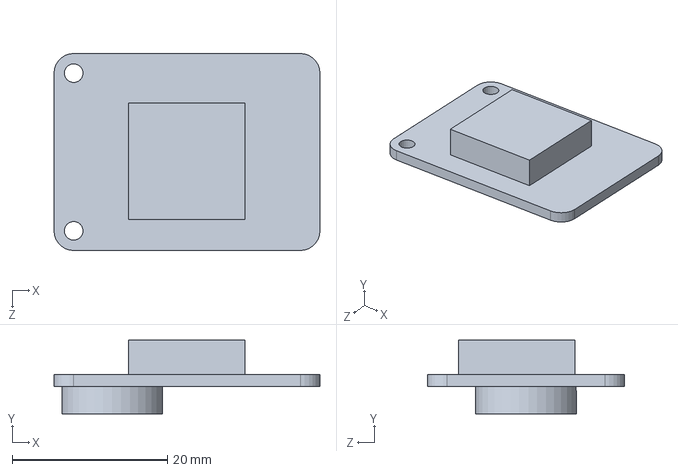
[picture p47: CAD file, 2022-10-21]
solidworks/ultimate GPS.SLDPRT
34.3 x 9.50 x 25.4 mm
