dwkennedy/ballooning/solidworks/rope stop.SLDPRT

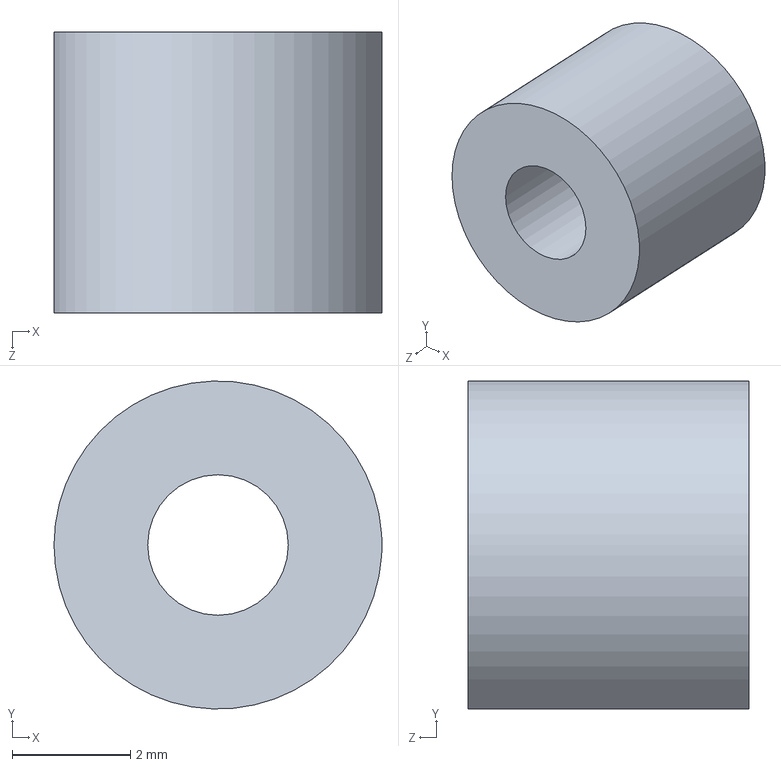
[picture p48: CAD file, 2022-10-21]
solidworks/rope stop.SLDPRT
5.56 x 5.55 x 4.76 mm
