dwkennedy/ballooning/solidworks/spool flange.SLDPRT

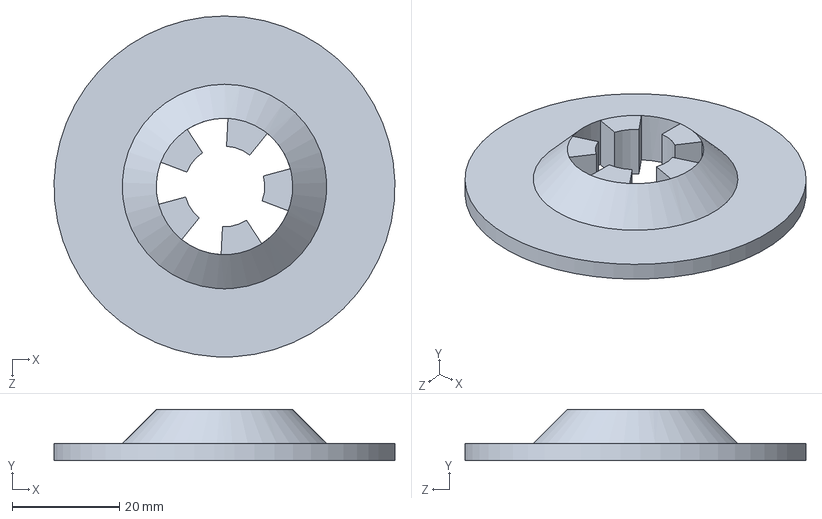
[picture p49: CAD file, 2022-10-21]
solidworks/spool flange.SLDPRT
63.5 x 9.53 x 63.5 mm
