dwkennedy/ballooning/solidworks/rockblock.SLDPRT

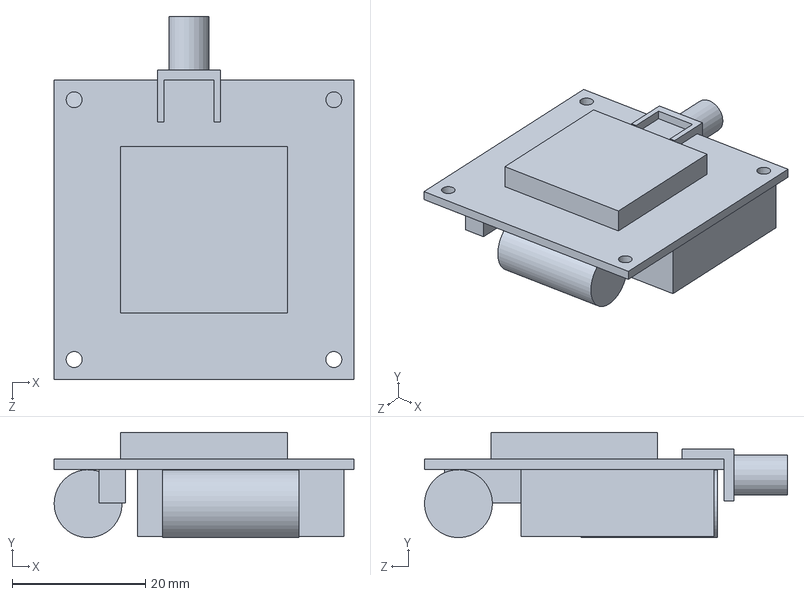
[picture p50: CAD file, 2022-10-21]
solidworks/rockblock.SLDPRT
45.0 x 15.8 x 54.5 mm
