dwkennedy/ballooning/solidworks/plunger.SLDPRT

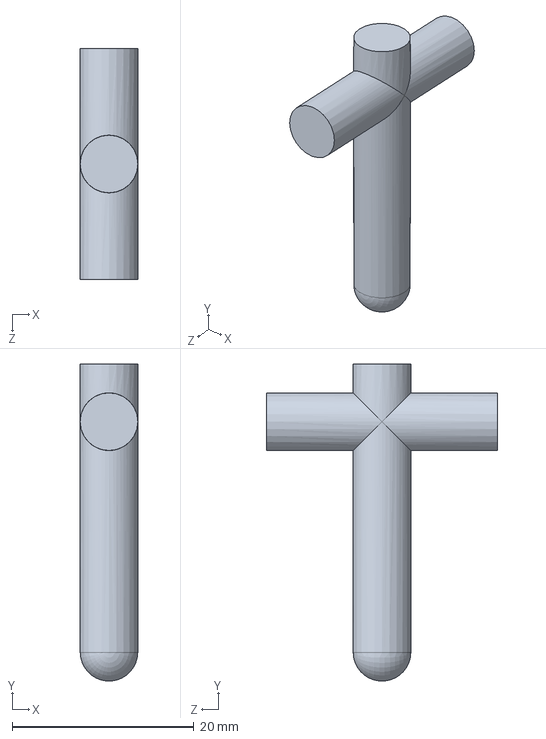
[picture p51: CAD file, 2022-09-23]
solidworks/plunger.SLDPRT
6.35 x 34.9 x 25.4 mm
