dwkennedy/ballooning/solidworks/axle.SLDPRT

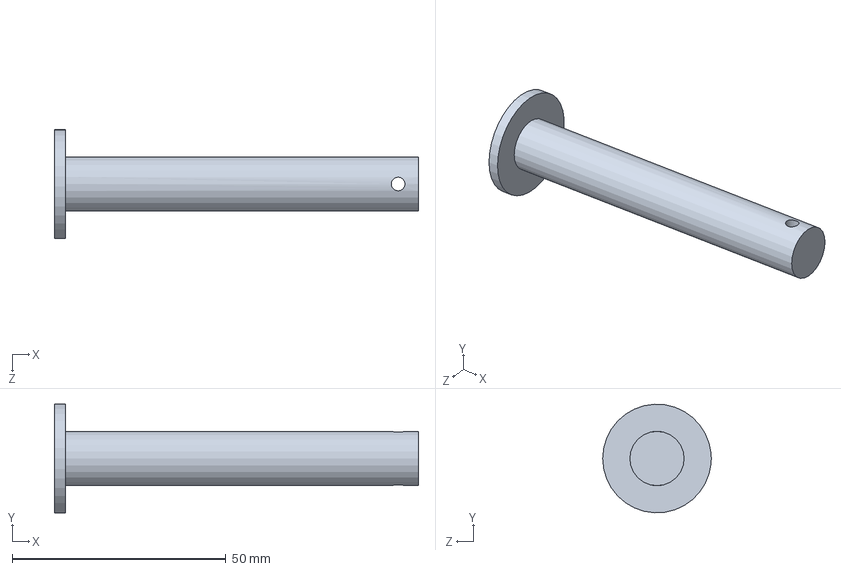
[picture p52: CAD file, 2022-09-23]
solidworks/axle.SLDPRT
85.1 x 25.4 x 25.4 mm
