dwkennedy/ballooning/solidworks/motor shaft.SLDPRT

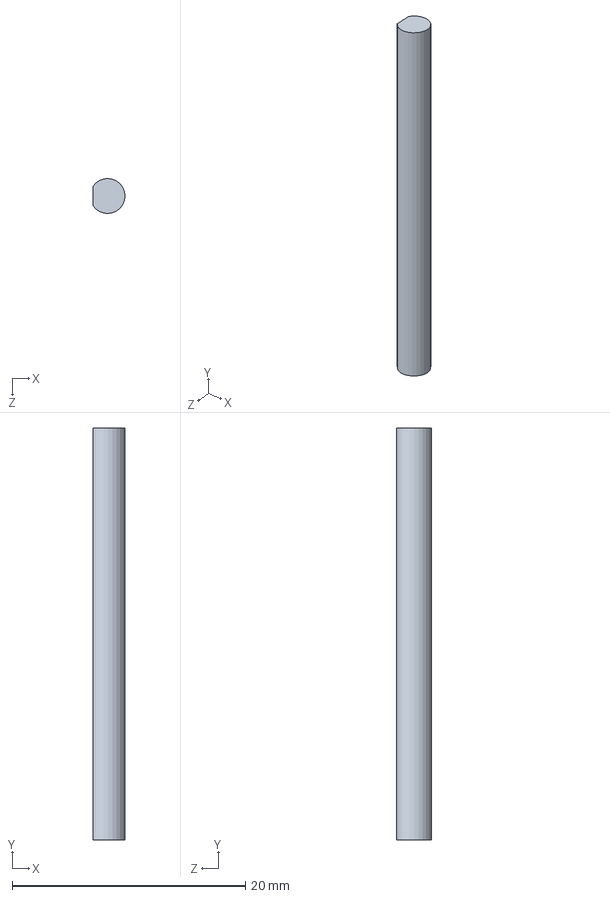
[picture p53: CAD file, 2022-09-23]
solidworks/motor shaft.SLDPRT
2.75 x 35.3 x 3.00 mm
