dwkennedy/ballooning/solidworks/servo arm.SLDPRT

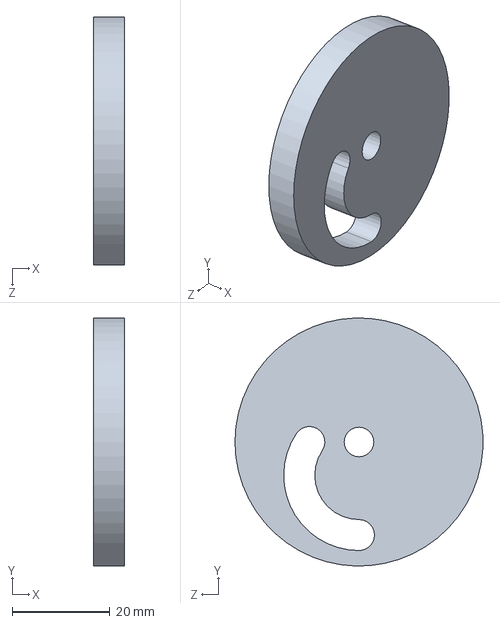
[picture p54: CAD file, 2022-09-23]
solidworks/servo arm.SLDPRT
6.35 x 50.8 x 50.8 mm
