dwkennedy/ballooning/solidworks/axle spacer.SLDPRT

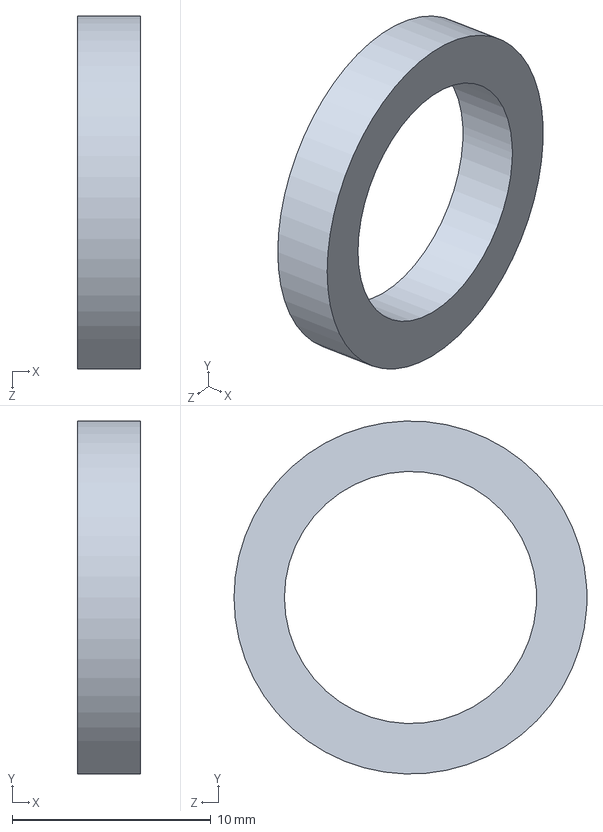
[picture p55: CAD file, 2022-09-23]
solidworks/axle spacer.SLDPRT
3.17 x 17.8 x 17.8 mm
