dwkennedy/ballooning/solidworks/D-profile rotary shaft 6mm.SLDPRT

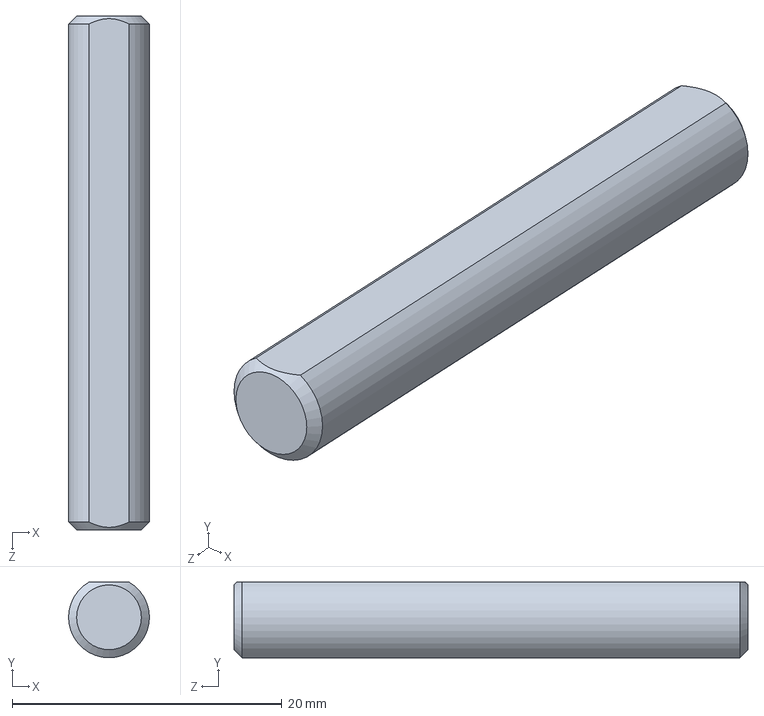
[picture p56: CAD file, 2022-09-23]
solidworks/D-profile rotary shaft 6mm.SLDPRT
6.00 x 5.60 x 38.1 mm
