dwkennedy/ballooning/solidworks/servo axle.SLDPRT

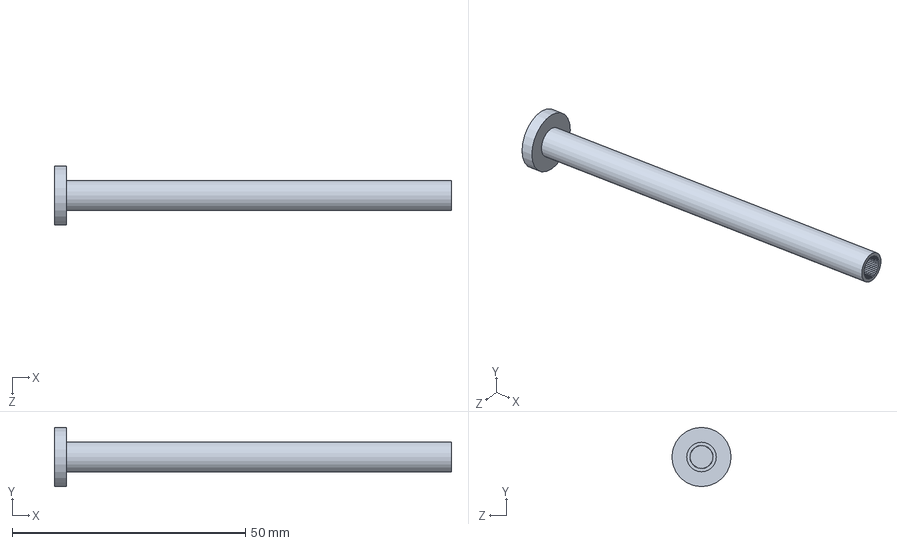
[picture p57: CAD file, 2022-09-23]
solidworks/servo axle.SLDPRT
85.1 x 12.7 x 12.7 mm
