dwkennedy/ballooning/solidworks/motor body.SLDPRT

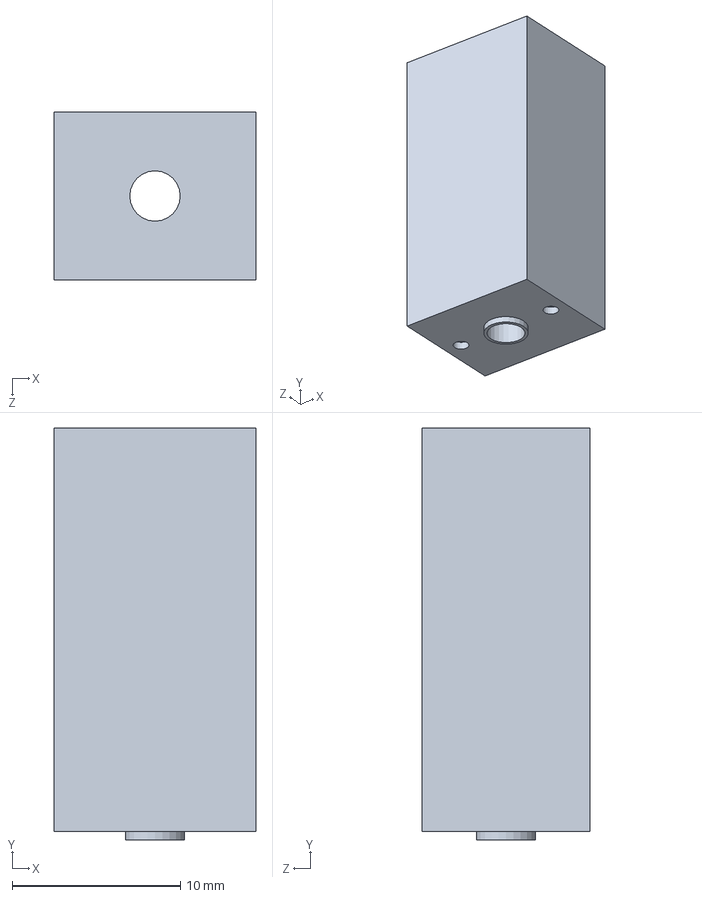
[picture p58: CAD file, 2022-09-23]
solidworks/motor body.SLDPRT
12.0 x 24.5 x 10.0 mm
