dwkennedy/ballooning/(list of files, cad)

Other CAD files:
solidworks/128951095-7-1757019-2/line holder.SLDASM
solidworks/hot wire cutter assembly mount.SLDPRT
solidworks/hot wire cutter assembly holder.SLDPRT
solidworks/STL/bulkhead body TOP.STL
solidworks/STL/bulkhead body small BOTTOM.STL
solidworks/bulkhead body small.SLDPRT
solidworks/Part3.SLDPRT
solidworks/enclosure brace.SLDPRT
solidworks/pxc_1840366_05_MC-1-5-2-ST-3-5_3D.stp
solidworks/rigging pog.SLDPRT
solidworks/pxc_1844210_05_MC-1-5-2-G-3-5_3D.stp
solidworks/128951095-7-1757019-2/1769463.SLDPRT
solidworks/128951095-7-1757019/1757019.SLDASM
solidworks/128951095-7-1757019/1757019_01.SLDPRT
solidworks/128951095-7-1757019/1757019_02.SLDPRT
solidworks/128951095-7-1757019/1757019_03.SLDPRT
solidworks/2662N332_20 Degree Pressure Angle Plastic Gear 12mm.SLDPRT
solidworks/2662N43_20 Degree Pressure Angle Plastic Gear_60mm.SLDPRT
solidworks/57545K633_Steel Worm.SLDPRT
solidworks/8632T144_D-Profile Rotary Shaft.SLDPRT
solidworks/8694K141_Light Duty Blended EPDM Foam Strip.SLDPRT
solidworks/8880K83_Easy-to-Form Nickel Chromium Alloy.SLDPRT
solidworks/90003A029_Nylon 6 6 Plastic Cap Nut.SLDPRT
solidworks/91223A413_316 Stainless Steel Ultra-Low-Profile Socket Head Screw.SLDPRT
solidworks/91770A548_Extra-Wide Truss Head Phillips Screws.SLDPRT
solidworks/91770A550_Extra-Wide Truss Head Phillips Screws.SLDPRT
solidworks/91772A081_Passivated 18-8 Stainless Steel Pan Head Phillips Screw.SLDPRT
solidworks/91772A084_Passivated 18-8 Stainless Steel Pan Head Phillips Screw.SLDPRT
solidworks/91772A205_Passivated 18-8 Stainless Steel Pan Head Phillips Screw.SLDPRT
solidworks/91970A550_Black Nylon Hex Head Screws.SLDPRT
solidworks/92125A126_18-8 Stainless Steel Hex Drive Flat Head Screw.SLDPRT
solidworks/92125A128_18-8 Stainless Steel Hex Drive Flat Head Screw.SLDPRT
solidworks/92125A130_18-8 Stainless Steel Hex Drive Flat Head Screw m3-10mm.SLDPRT
solidworks/92703A149_18-8 Stainless Steel Torx Flat Head Screws.SLDPRT
solidworks/93565K118_Super-Cushioning Polyethylene Foam Strip.SLDPRT
solidworks/94459A413_Heat-Set Inserts for Plastic.SLDPRT
solidworks/94639A332_Off-White Nylon Unthreaded Spacer.SLDPRT
solidworks/94639A335_Off-White Nylon Unthreaded Spacer.SLDPRT
solidworks/94639A341_Off-White Nylon Unthreaded Spacer.SLDPRT
solidworks/94639A401_Off-White Nylon Unthreaded Spacer.SLDPRT
solidworks/94639A431_Off-White Nylon Unthreaded Spacer.SLDPRT
solidworks/94639A469_Off-White Nylon Unthreaded Spacer.SLDPRT
solidworks/94639A711_Off-White Nylon Unthreaded Spacer.SLDPRT
solidworks/94735A264_Nylon Pan Head Screws.SLDPRT
solidworks/94735A265_Nylon Pan Head Screws.SLDPRT
solidworks/94735A266_Nylon Pan Head Screws.SLDPRT
solidworks/9686T76_Routing Eyebolt with Nut - Not for Lifting.SLDPRT
solidworks/97171A160_Brass Heat-Set Inserts for Plastic.SLDPRT
solidworks/97171A230_Brass Heat-Set Inserts for Plastic.SLDPRT
solidworks/9753K538_Round Caps.SLDPRT
solidworks/9753K538_Round Caps_with_oblong_hole.SLDPRT
solidworks/97654A675_18-8 Stainless Steel Flanged Button Head Screw.SLDPRT
solidworks/98320A140_Zinc-Plated Steel Ring-Grip Quick-Release Pin.SLDPRT
solidworks/98404A959_18-8 Stainless Steel Ring-Grip Quick-Release Pin.SLDPRT
solidworks/98404A960_18-8 Stainless Steel Ring-Grip Quick-Release Pin.SLDPRT
solidworks/9939T314_Vibrate-Damping Precision Flexible Shaft Coupling.SLDPRT
solidworks/9939T444_Durometer 98A Spider for 21 mm OD Set Screw Vibrate-Damping Precision Flexible Shaft Coupling.SLDPRT
solidworks/MBZ1_xxxC02X02.SLDASM
solidworks/STL/bulkhead nut small.STL
solidworks/STL/bulkhead nut.STL
solidworks/STL/enclosure brace BOTTOM 2 hole.STL
solidworks/STL/enclosure brace BOTTOM.STL
solidworks/STL/enclosure brace TOP.STL
solidworks/STL/left receiver plate.STL
solidworks/STL/right receiver plate.STL
solidworks/STL/spool axle LARGE.STL
solidworks/STL/spool flange LARGE.STL
solidworks/STL/spool flange.STL
solidworks/bulkhead nut small.SLDPRT
solidworks/bulkhead nut.SLDPRT
solidworks/enclosure brace TOP v2.SLDPRT
solidworks/enclosure brace TOP v3.SLDPRT
