dwkennedy/ballooning/hardware/PCB final 20221029.pdf

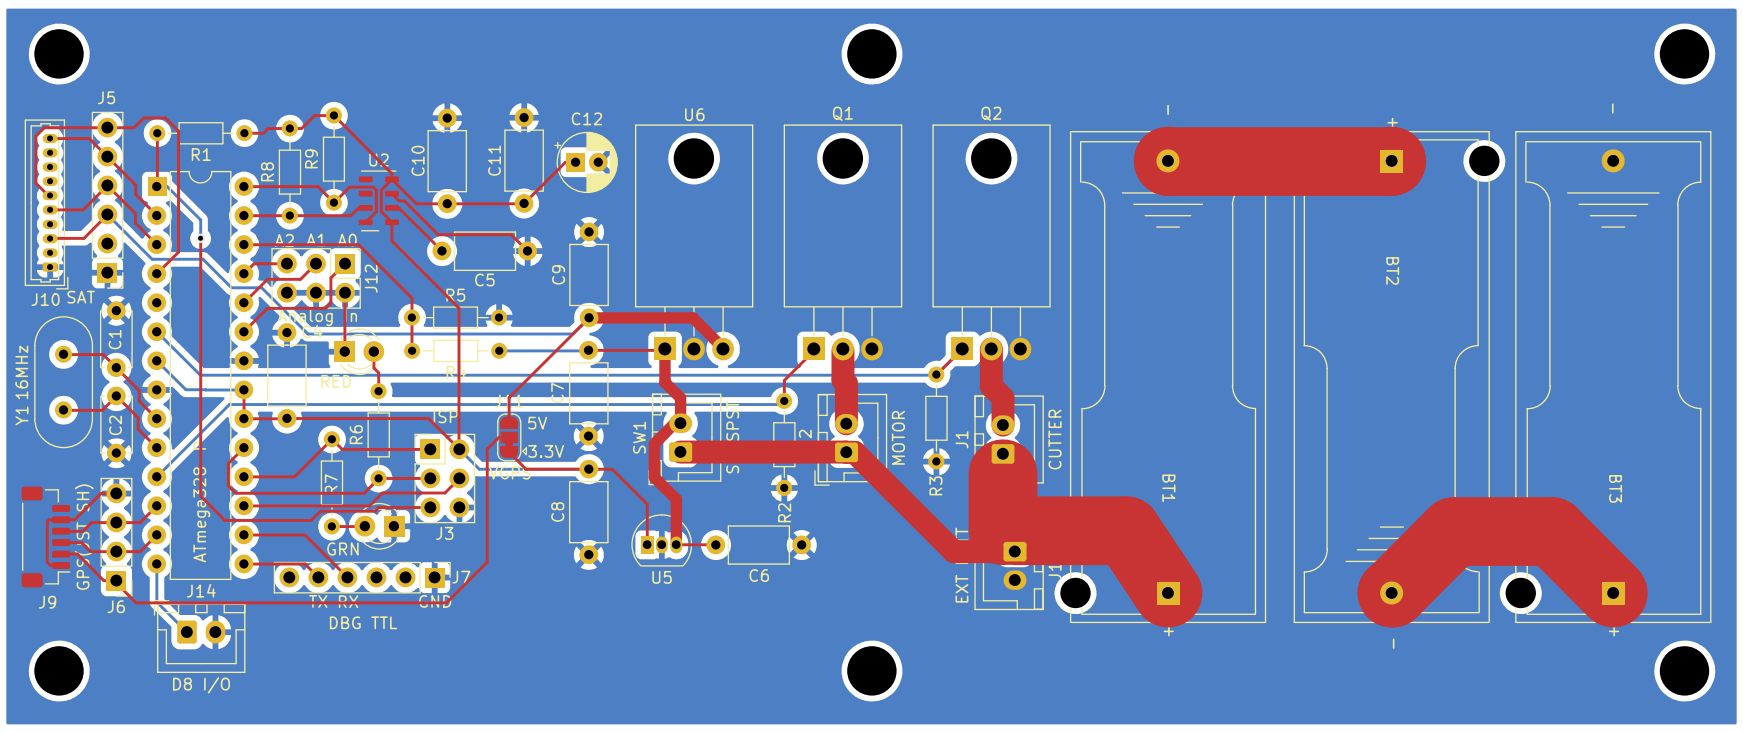
[picture p65: page 1]
