dwkennedy/ballooning/hardware/schematic 20221029.pdf

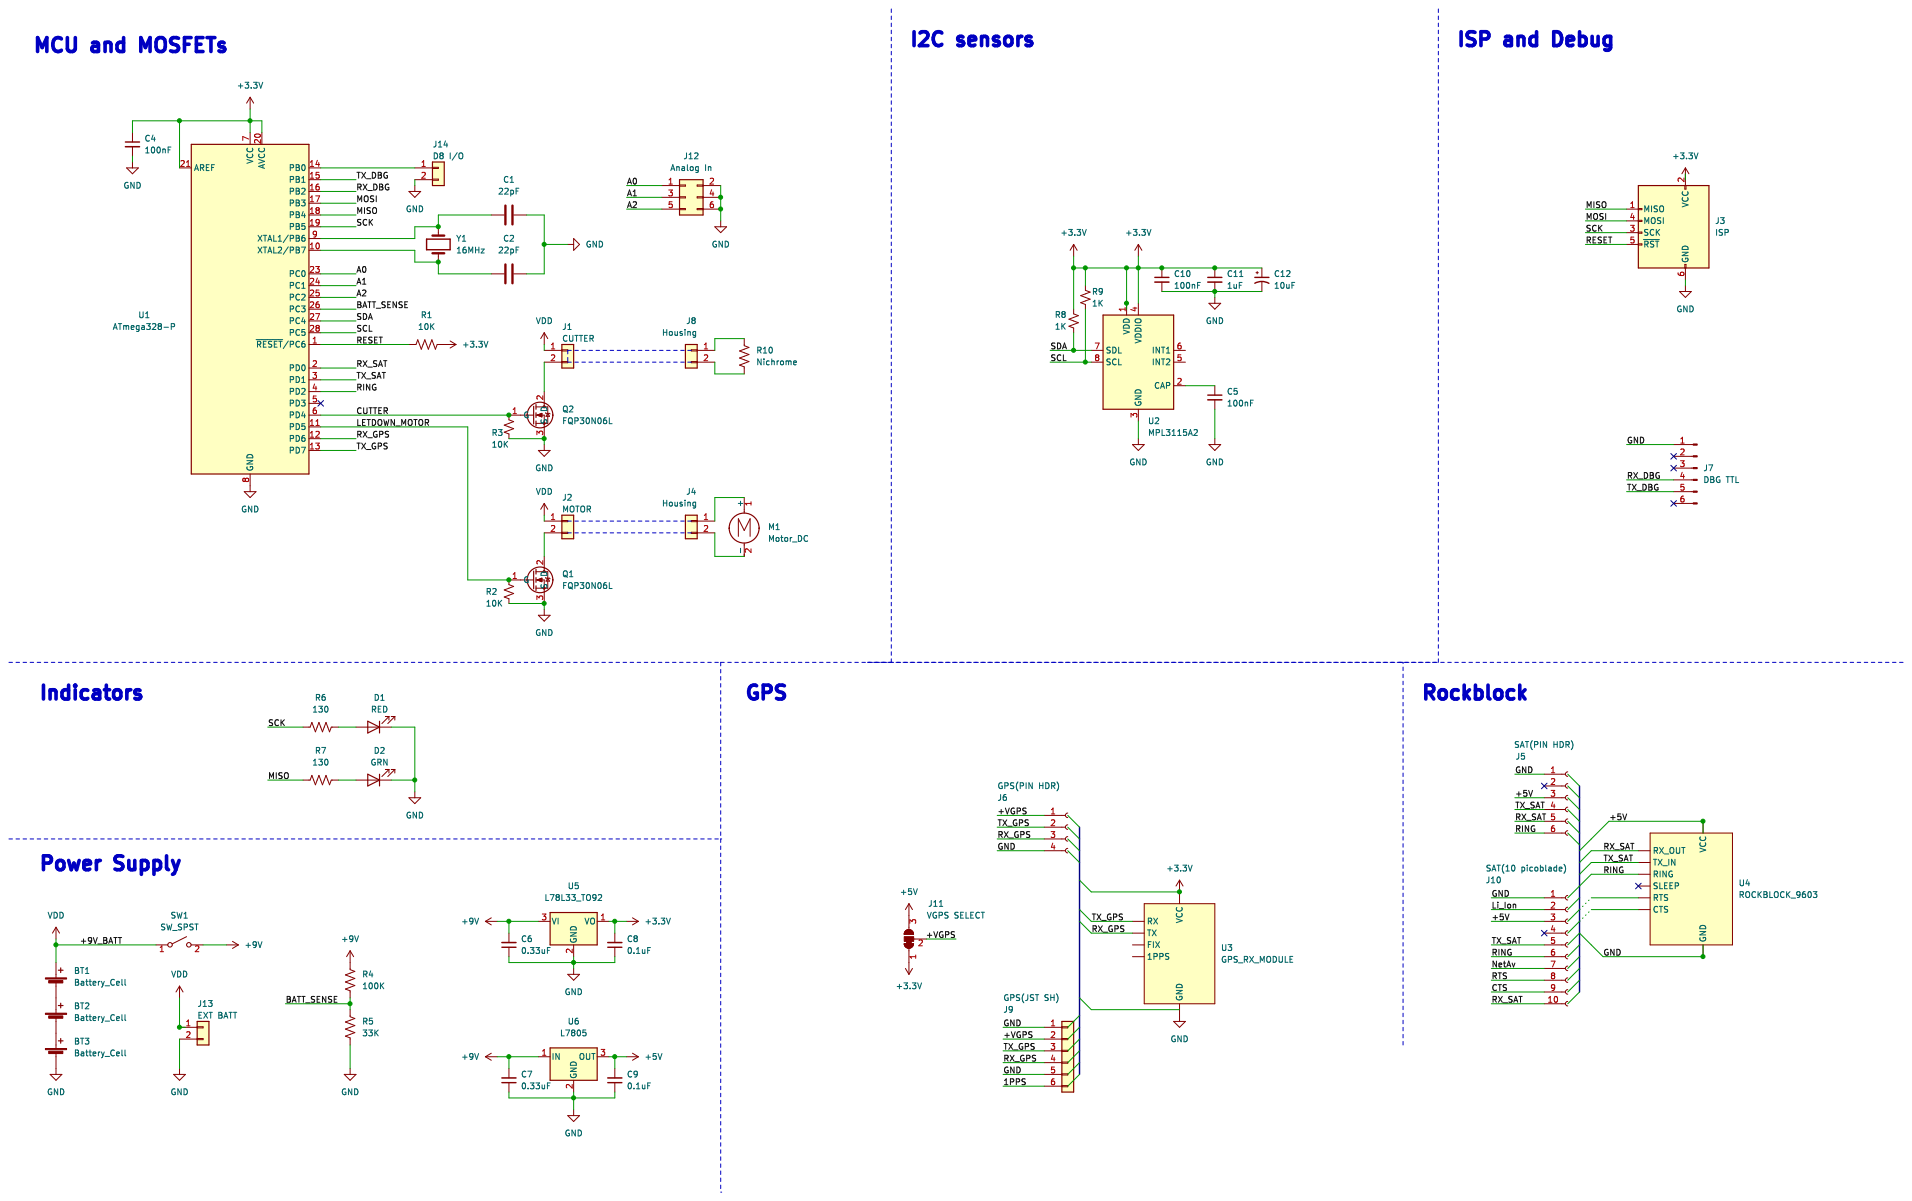
[picture p66: page 1]
