dwkennedy/ballooning/hardware/cut down control board.kicad_pcb

## KiCad design hardware/cut down control board.kicad_pcb (2022-10-28)

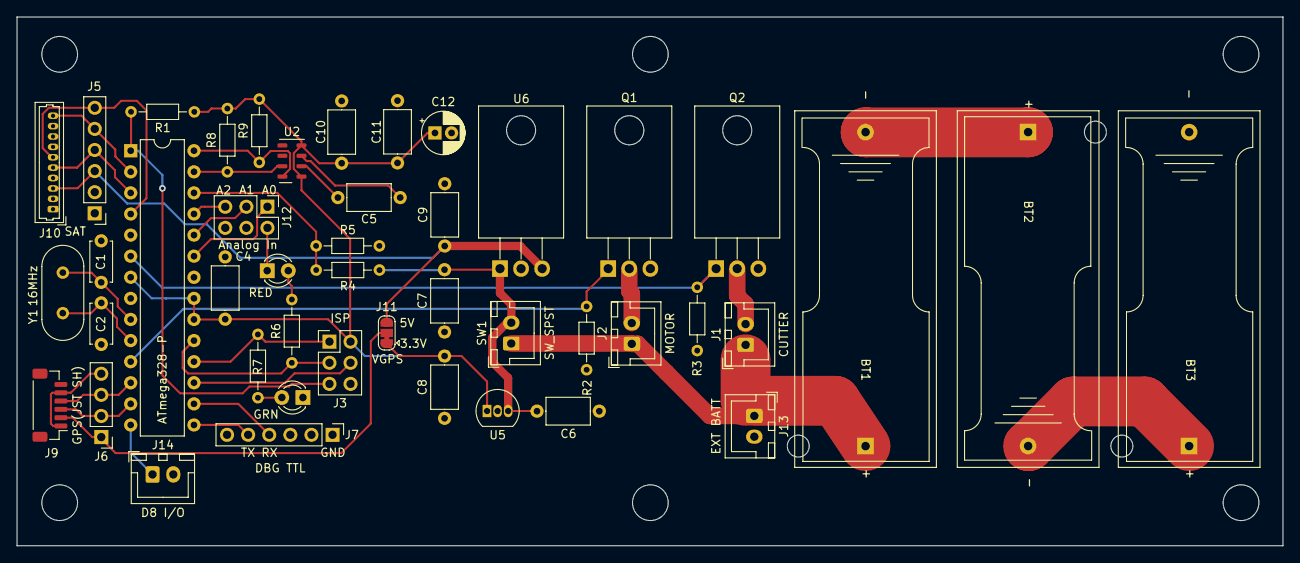
[picture p67: board cut down control board.kicad_pcb from above]

Board: 2 copper layers, 152.4 x 63.7 mm, 45 parts (0 on the bottom side), 35 nets.

Parts:
BT1, BT2, BT3: Battery_Cell; BatteryHolder_Keystone_1051_1xCR123A
C1, C2: 22pF; C_Disc_D4.7mm_W2.5mm_P5.00mm
C4, C5, C10: 100nF; C_Axial_L5.1mm_D3.1mm_P7.50mm_Horizontal
C6, C7: 0.33uF; C_Axial_L5.1mm_D3.1mm_P7.50mm_Horizontal
C8, C9: 0.1uF; C_Axial_L5.1mm_D3.1mm_P7.50mm_Horizontal
C11: 1uF; C_Axial_L5.1mm_D3.1mm_P7.50mm_Horizontal
C12: 10uF; CP_Radial_D5.0mm_P2.00mm
D1: RED; LED_D3.0mm
D2: GRN; LED_D3.0mm
J1: CUTTER; JST_XH_B2B-XH-A_1x02_P2.50mm_Vertical
J2: MOTOR; JST_XH_B2B-XH-A_1x02_P2.50mm_Vertical
J3: ISP; PinHeader_2x03_P2.54mm_Vertical
J5: SAT(PIN HDR); PinHeader_1x06_P2.54mm_Vertical
J6: GPS(PIN HDR); PinHeader_1x04_P2.54mm_Vertical
J7: DBG TTL; PinHeader_1x06_P2.54mm_Vertical
J9: GPS(JST SH); JST_SH_BM06B-SRSS-TB_1x06-1MP_P1.00mm_Vertical
J10: SAT(10 picoblade); Molex_PicoBlade_53047-1010_1x10_P1.25mm_Vertical
J11: VGPS SELECT; SolderJumper-3_P1.3mm_Bridged12_RoundedPad1.0x1.5mm
J12: Analog In; PinHeader_2x03_P2.54mm_Vertical
J13: EXT BATT; JST_XH_B2B-XH-A_1x02_P2.50mm_Vertical
J14: D8 I/O; JST_XH_B2B-XH-A_1x02_P2.50mm_Vertical
Q1, Q2: FQP30N06L; TO-220-3_Horizontal_TabDown
R1, R2, R3: 10K; R_Axial_DIN0204_L3.6mm_D1.6mm_P7.62mm_Horizontal
R4: 100K; R_Axial_DIN0204_L3.6mm_D1.6mm_P7.62mm_Horizontal
R5: 33K; R_Axial_DIN0204_L3.6mm_D1.6mm_P7.62mm_Horizontal
R6, R7: 130; R_Axial_DIN0204_L3.6mm_D1.6mm_P7.62mm_Horizontal
R8, R9: 1K; R_Axial_DIN0204_L3.6mm_D1.6mm_P7.62mm_Horizontal
SW1: SW_SPST; JST_XH_B2B-XH-A_1x02_P2.50mm_Vertical
U1: ATmega328-P; DIP-28_W7.62mm
U2: MPL3115A2; NXP_LGA-8_3x5mm_P1.25mm_H1.1mm
U5: L78L33_TO92; TO-92_Inline
U6: L7805; TO-220-3_Horizontal_TabDown
Y1: 16MHz; Crystal_HC49-4H_Vertical

Connections:
+3.3V: C4.1, C8.2, C10.1, C11.1, C12.1, J3.2 (VCC), J11.1 (A), R1.1, R8.2, R9.2, U1.7 (VCC), U1.20 (AVCC), U1.21 (AREF), U2.1 (VDD), U2.4 (VDDIO), U5.1 (VO)
+5V: C9.2, J5.3, J10.3, J11.3 (B), U6.3 (OUT)
+9V: C6.2, C7.2, R4.1, SW1.2 (B), U5.3 (VI), U6.1 (IN)
/+VGPS: J6.1, J9.2, J11.2 (C)
/A0: J12.1, U1.23 (PC0)
/A1: J12.3, U1.24 (PC1)
/A2: J12.5, U1.25 (PC2)
/BATT_SENSE: R4.2, R5.1, U1.26 (PC3)
/CUTTER: Q2.1 (G), R3.1, U1.6 (PD4)
/LETDOWN_MOTOR: Q1.1 (G), R2.1, U1.11 (PD5)
/MISO: J3.1 (MISO), R7.1, U1.18 (PB4)
/MOSI: J3.4 (MOSI), U1.17 (PB3)
/RESET: J3.5 (~RST), R1.2, U1.1 (~RESET/PC6)
/RING: J5.6, J10.6, U1.4 (PD2)
/RX_DBG: J7.4, U1.16 (PB2)
/RX_GPS: J6.3, J9.4, U1.12 (PD6)
/RX_SAT: J5.5, J10.10, U1.2 (PD0)
/SCK: J3.3 (SCK), R6.1, U1.19 (PB5)
/SCL: R9.1, U1.28 (PC5), U2.8 (SCL)
/SDA: R8.1, U1.27 (PC4), U2.7 (SDL)
/TX_DBG: J7.5, U1.15 (PB1)
/TX_GPS: J6.2, J9.3, U1.13 (PD7)
/TX_SAT: J5.4, J10.5, U1.3 (PD1)
GND: BT3.2 (-), C1.2, C2.2, C4.2, C5.2, C6.1, C7.1, C8.1, C9.1, C10.2, C11.2, C12.2, D1.1 (K), D2.1 (K), J3.6 (GND), J5.1, J6.4, J7.1, J9.1, J9.5, J10.1, J12.2, J12.4, J12.6, J13.2, J14.2, Q1.3 (S), Q2.3 (S), R2.2, R3.2, R5.2, U1.8 (GND), U1.22 (GND), U2.3 (GND), U5.2 (GND), U6.2 (GND)
unnamed: BT1.2 (-), BT2.1 (+)
unnamed: BT2.2 (-), BT3.1 (+)
unnamed: C1.1, U1.9 (XTAL1/PB6), Y1.2
unnamed: C2.1, U1.10 (XTAL2/PB7), Y1.1
unnamed: C5.1, U2.2 (CAP)
unnamed: D1.2 (A), R6.2
unnamed: D2.2 (A), R7.2
unnamed: J1.2, Q2.2 (D)
unnamed: J2.2, Q1.2 (D)
unnamed: J14.1, U1.14 (PB0)
VDD: BT1.1 (+), J1.1, J2.1, J13.1, SW1.1 (A)
