dwkennedy/ballooning/config tools/configure.py

# This a program to configure the ballooning device

import struct
import serial
from time import sleep
import sys
import re
import json
import datetime
import requests
import crcmod

global serialnumber
global imei

def build_config_struct():

# elevator test; letdown 30 sec after launch, then flight ends 60 after launch
    global serialnumber
    global imei
    global program_flag

    # 0= read config/upload to database only, 1= program and then read config/upload to database
    program_flag = 1
    # use serial number from Iridium modem; should match IMEI read from modem
    serialnumber = 209879
    # only set IMEI if you want to override what is returned from device
    #imei = "300434066196920"

#    serialnumber = 209825
#    imei = "300434066190990"

    serialnumber = 211176
    imei = "30043406754370"
    unit_id = 1176

    letdown_delay = -30  # positive: seconds after launch detect: negative, seconds after power on
    letdown_duration = 1  # seconds
    max_flight_duration = 300 # SECONDS, 0=ignore
    cut_pressure = 0      # Pascals, 0=ignore
    cut_duration = 3000  # milliseconds
    rise_rate_threshold = 85  # Pa/sec * conversion factor: NWC elevator is 100
    update_interval_satellite = 60  # SECONDS, 0 = no update
    max_distance = 0  # meters, 0=ignore
    min_latitude = 34000000  # millionths of degrees, ie 35.123456 = 35123456, 0=ignore
    max_latitude = 36000000
    min_longitude = -98000000
    max_longitude = -96000000

    if (0):   # lloyd noble drive test
        serialnumber = 209879
        imei = "300434066196920"
        unit_id = 1235
        letdown_delay = 30  # positive: seconds after launch detect: negative, seconds after power on
        letdown_duration = 1  # seconds
        max_flight_duration = 300  # SECONDS, 0=ignore
        cut_pressure = 0  # Pascals, 0=ignore
        cut_duration = 10000  # milliseconds
        rise_rate_threshold = 85  # Pa/sec * conversion factor: NWC elevator is 100
        update_interval_satellite = 60  # SECONDS, 0 = no update
        max_distance = 0  # meters, 0=ignore
        min_latitude = 35185821  # millionths of degree, ie 35.123456 = 35123456, 0=ignore
        max_latitude = 35188899
        min_longitude = -97446539
        max_longitude = -97442332

    if (0):  # LEE configuration
        letdown_delay = 30  # positive: seconds after launch detect: negative, seconds after power on
        letdown_duration = 95  # seconds
        max_flight_duration = 60*60  # SECONDS, 0=ignore
        cut_pressure = 50000  # Pascals, 0=ignore
        cut_duration = 5000  # milliseconds
        rise_rate_threshold = 85  # Pa/sec * conversion factor: NWC elevator is 100
        update_interval_satellite = 120  # SECONDS, 0 = no update
        max_distance = 0  # meters, 0=ignore
        min_latitude = 43052242  # millionths of degrees, ie 35.123456 = 35123456, 0=ignore
        max_latitude = 44011595
        min_longitude = -76979028
        max_longitude = -75519990

    if (1):  # static test configuration
        letdown_delay = -30  # positive: seconds after launch detect: negative, seconds after power on
        letdown_duration = 10  # seconds
        max_flight_duration = 120  # SECONDS, 0=ignore
        cut_pressure = 0  # Pascals, 0=ignore
        cut_duration = 3000  # milliseconds
        rise_rate_threshold = 85  # Pa/sec * conversion factor: NWC elevator is 100
        update_interval_satellite = 120  # SECONDS, 0 = no update
        max_distance = 0  # meters, 0=ignore
        min_latitude = 0  # millionths of degrees, ie 35.123456 = 35123456, 0=ignore
        max_latitude = 0
        min_longitude = 0
        max_longitude = 0

    # fix swapped min/max
    if (min_longitude > max_longitude):
        temp = max_longitude
        max_longitude = min_longitude
        min_longitude = temp
    if (min_latitude > max_latitude):
        temp = max_latitude
        max_latitude = min_latitude
        min_latitude = temp

    config = struct.pack('< HhHHHHHHIiiii',
                         unit_id,
                         letdown_delay,
                         letdown_duration,
                         max_flight_duration,
                         cut_pressure,
                         cut_duration,
                         rise_rate_threshold,
                         update_interval_satellite,
                         max_distance,
                         min_latitude,
                         max_latitude,
                         min_longitude,
                         max_longitude)

    xmodem_crc_func = crcmod.mkCrcFun(0x11021, rev=False, initCrc=0x0000, xorOut=0x0000)
    config = config + struct.pack("> H", xmodem_crc_func(config))

    return config

def print_hi(name):
    # Use a breakpoint in the code line below to debug your script.
    print(f'Hi, {name}')  # Press Ctrl+F8 to toggle the breakpoint.

def dump_config(cfg):
    print("unit_id: %d" % cfg[0])

    if (cfg[1]<0):
        print("letdown_delay: %d seconds after power on" % abs(cfg[1]))
    else:
        print("letdown_delay: %d seconds after launch detect" % cfg[1])

    print("letdown_duration: %d seconds" % cfg[2])

    if (cfg[3]):
        print("max_flight_duration: %d seconds" % cfg[3])
    else:
        print("max_flight_duration: no limit")

    if (cfg[4]==0):
        print("cut_pressure: no limit")
    else:
        print("cut_pressure: %d Pa" % cfg[4])

    print("cut_duration: %d milliseconds" % cfg[5])

    print("rise_rate_threshold: %d" % cfg[6])

    if (cfg[7]>0):
        print("update_interval_satellite: %d" % cfg[7])
    else:
        print("update_interval_satellite: NO UPDATES")

    if (cfg[8]!=0):
        print("max_distance: %d meters" % cfg[8])
    else:
        print("max_distance: ignore")

    if (cfg[9]!=0):
        print("min_latitude: %f degrees N" % (cfg[9]/1000000))
    else:
        print("min_latitude: ignore")

    if (cfg[10]!=0):
        print("max latitude: %f degrees N" % (cfg[10]/1000000))
    else:
        print("max latitude: ignore")

    if (cfg[11]!=0):
        print("min longitude: %f degrees W" % (cfg[11]/1000000))
    else:
        print("min longitude: ignore")

    if (cfg[12]!=0):
        print("max longitude: %f degrees W" % (cfg[12]/1000000))
    else:
        print("max longitude: ignore")

    print("CRC16 checksum: 0x%x" % cfg[13])

def unpack_config_struct(buffer):
    config = struct.unpack('< HhHHHHHHIiiiiH', buffer)
    return config


# Press the green button in the gutter to run the script.
if __name__ == '__main__':

    config_bytes = build_config_struct()
    cfg = unpack_config_struct(config_bytes)
    print("\r\nConfiguration requested")
    print("---------------------")
    dump_config(cfg)

    cfgRegex = re.compile(b'CFG ([0-9A-Fa-f]{76})')  # regex to find configuration struct from BAD output.  config vector is 38 bytes
    imeiRegex = re.compile(b'IMEI ([0-9]{15})')  # regex to find iridium modem imei from BAD output

    print("")
    if (len(sys.argv)<2):
        port = "COM3"
    else:
        port = sys.argv[1]

    print("Hex string for programming RockBLOCK: " + b"CFG".hex() + config_bytes.hex())

    try:
        serialPort = serial.Serial(port=port, baudrate=19200,
                               bytesize=8, timeout=0.5, stopbits=serial.STOPBITS_ONE)
    except Exception as e:
        print(e)
        print("Check serial port in device manager!")
        quit(1)

    while serialPort.in_waiting:
        print(serialPort.read(serialPort.in_waiting)) # purge buffer
        sleep(0.100)

    print("Connect cable and turn on device now")

    #wait for first character
    while (serialPort.in_waiting<=0):
        None

    sleep(2.0)
    # purge all arriving characters
    while (serialPort.in_waiting):
        #print(serialPort.read(serialPort.in_waiting))
        print(serialPort.readline().decode('UTF-8').rstrip())
        #sleep(0.100)

    if(program_flag):
        print("Programming device...")
        try:
            for i in range(1,10):
                print("tx: " + str(b'PRG' + config_bytes))
                serialPort.write(b'PRG' + config_bytes)
                for j in range(1,10):
                    foo = serialPort.readline()
                    if (foo):
                        print(foo.decode('UTF-8').rstrip())
                        if (foo==b'OK\r\n'):
                            raise StopIteration
                        if (foo==b'ERR\r\n'):
                            sleep(0.1)
                            break
        except StopIteration:
            serialPort.write(b'END')
            print("Programming success!")

    else:
        serialPort.write(b'END')

    print("Reading back configuration from device")

    for i in range(1,10):
        foo = serialPort.readline()    # (serialPort.in_waiting)
        print(foo.decode('UTF-8').rstrip())
        try:
            if("imei" not in locals()):
                search = imeiRegex.search(foo)
                if(search):
                    imei = search.group(1).decode('UTF-8')
                    print("\r\nIMEI is " + imei)

            search = cfgRegex.search(foo)
            if(search):
                #print("found: " + str(search.groups()))
                hexbytes = search.group(1)  # regex searches the bytes; hexbytes is bytes format, of ascii values encoding hex
                #print("group(1): " + str(dump))
                cfgbytes = bytes.fromhex(hexbytes.decode('UTF-8'))  # convert the ascii hex bytes to byte string (00-FF values in each position)
                if(cfgbytes):
                    xmodem_crc_func = crcmod.mkCrcFun(0x11021, rev=False, initCrc=0x0000, xorOut=0x0000)
                    if (xmodem_crc_func(cfgbytes)):
                        print("CRC16 error detected")
                    cfg = unpack_config_struct(cfgbytes)   # unpack the bytes of the struct into cfg tuple
                    print("\r\nConfiguration as read")
                    print("---------------------")
                    dump_config(cfg)  # dump the configuration tuple in readable format
                    break
        except Exception as e:
            print("something scrammed in regex/conversion to bytes/struct unpack!")
            print(str(e))
            pass

    if ('hexbytes' in locals()):
        print("\r\nSubmitting configuration as read back from device to database")
        # goofed up by bug in CFG code in firmware, fix later DWK
        #data = b'CFG'.hex() + hexbytes.decode('UTF-8')  # this is the data JSON that comes from rock 7 to the web server
        data = b'CFG'.hex() + hexbytes.decode('UTF-8')  # this is the data JSON that comes from rock 7 to the web server
        transmit_time = datetime.datetime.utcnow().strftime('%Y-%m-%d %H:%M:%S')
        #  sample--> data = '4346479726E2FF0F0000000000102755003C000000000080CC06020051250280A328FA002847FAF99B';
        payload = {'data': data,
                'imei': imei,
                'serial': serialnumber,
                'device_type': 'SERIAL',
                'transmit_time': transmit_time,
                'momsn': 0,
                'iridium_latitude': 0,
                'iridium_longitude': 0,
                'iridium_cep': 0
                }
        print(payload)
        try:
            result = requests.post("http://kennedy.tw:8000/waypoint", json=payload)
            print("server response (200=SUCCESS): " + str(result.status_code))
            #print(result.json()) +
        except Exception as e:
            print("server error: " + str(e))
    else:
        print("Configuration not read back from device, please try again")

# See PyCharm help at https://www.jetbrains.com/help/pycharm/
"""
struct eeprom_config {
  uint16_t unit_id;
  int16_t letdown_delay; // (seconds; positive: letdown X seconds after launch detect; negative: letdown, letdown X seconds after power on)
  uint16_t letdown_duration; // (seconds, 0=disable)
  uint16_t max_flight_duration; // seconds (0=ignore)
  uint16_t cut_pressure; //  Pa.  (0=ignore)
  uint16_t cut_duration; // (milliseconds)
  uint16_t rise_rate_threshold; //  (digital units, see test data)
  uint16_t update_interval_satellite; // (seconds, 0=no update)
  uint32_t max_distance;  // (meters, 0=disable)
  int32_t min_latitude;  // (millionths of degrees)
  int32_t max_latitude;  // (millionths of degrees)
  int32_t min_longitude; // (millionths of degrees)
  int32_t max_longitude; // (millionths of degrees)
};   'HhHHHHHHHIiiii'

#  also add two byte CRC16-XMODEM at the end
"""
