dwkennedy/ballooning/(commit log)

2018-12-29 Add files via upload
    Arduino implementation of FIR slope filter with MS5611 pressure sensor
2022-08-18 Add files via upload
    code for let down reel/ cut down device using BMP180 pressure sensor
2022-08-18 Add files via upload
    sketch of circuit
2022-08-30 Add files via upload
    fix to status message update interval
    [bmp180_state_engine.ino]
2022-08-31 Add files via upload
    added some links to special libraries used and board manager URL for bare atmega328p
    http://www.bamfordresearch.com/files/package_jb23_insystemmcu_index.json
2022-08-31 Add files via upload
    add gps update code and calculation of distance over surface of earth from launch to balloon
    add gps LED code (blink LED_GPS port if a lock; off=no lock)
2022-08-31 Add files via upload
    fixed bug in haversine testing code (constant with leading zero interpreted as octal by compiler)
    fixed some other minor bugs
    removed debugging code
    [bmp180_state_engine.ino]
2022-09-01 Add files via upload
    added code for Honeywell MPR pressure sensor
    improved timing for pressure sensor sampling
2022-09-04 Add files via upload
    wired DO 8 to reset pin on MPR pressure sensor
    defined RESET_PIN in code to reset the sensor on boot
    modified adafruit MPR library to use only integer math and return integer value of pressure in Pa
    [bmp180_state_engine.ino]
2022-09-04 Add files via upload
    modified adafruit MPR library to read pressure and convert to Pa using only integer math
2022-09-04 Add files via upload
    setting update interval to zero disables the update
    fix up the debug code to use #ifdef
    [bmp180_state_engine.ino]
2022-09-04 Add files via upload
    (n-1) % N can produce -1 if n is an int so I made n a uint16_t. n is the index into the circular buffer of samples so 0<= n < N, i.e. n= 0..(N-1)
2022-09-04 Add files via upload
    add delay to avoid double blink/reset on power on
    [bmp180_state_engine.ino]
2022-09-04 Add files via upload
    LED flash when pressure is missing/invalid
    [bmp180_state_engine.ino]
2022-09-18 Add files via upload
    script to send configuration commands to device on power up
2022-09-20 Add files via upload
    added MPL3115A2 sensor support
    rockblock RING ping support
    fixed course/speed scaling (100ths of degrees and 100ths of knots)
    initialized MT_buffer_size correctly before SBD tx/rx
    analog input 3 monitors battery voltage. 4:1 voltage divider (range=3.3*4 = 13.2)
    [ballooning_state_engine.h, ballooning_state_engine.ino]
2022-09-23 move additional files
    solidworks, etc
    [2662N332_20 Degree Pressure Angle Plastic Gear 12mm.SLDPRT, 2662N43_20 Degree Pressure Angle Plastic Gear_60mm.SLDPRT, 57545K633_Steel Worm.SLDPRT, 8632T144_D-Profile Rotary Shaft.SLDPRT, 90003A029_Nylon 6 6 Plastic Cap Nut.SLDPRT, 91223A413_316 Stainless Steel Ultra-Low-Profile Socket Head Screw.SLDPRT, 91970A550_Black Nylon Hex Head Screws.SLDPRT, 92125A126_18-8 Stainless Steel Hex Drive Flat H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]
2022-09-23 added more solidworks files
    [1757019.SLDASM, 1757019_01.SLDPRT, 1757019_02.SLDPRT, 1757019_03.SLDPRT, 1769463.SLDPRT, big motor body.SLDPRT, line holder.SLDASM]
2022-09-23 added kicad project
    [cut down control board.kicad_pcb, cut down control board.kicad_sch, cut down control board.sch]
2022-09-23 testing github change
    [cut down control board.kicad_pcb]
2022-09-25 added footprints
    [cut down control board.kicad_pcb]
2022-09-27 update pcb layout
    [cut down control board.kicad_pcb]
2022-09-27 More updates to PCB
    [cut down control board.kicad_pcb, cut down control board.kicad_sch]
2022-09-29 board layout
    [cut down control board.kicad_pcb, cut down control board.kicad_sch]
2022-09-30 changed footprint J2
    [cut down control board.kicad_pcb]
2022-10-12 finished board, generated gerbers
    [cut down control board-B_Cu.gbr, cut down control board-B_Mask.gbr, cut down control board-B_Paste.gbr, cut down control board-B_Silkscreen.gbr, cut down control board-Edge_Cuts.gbr, cut down control board-F_Cu.gbr, cut down control board-F_Mask.gbr, cut down control board-F_Paste.gbr]
2022-10-12 Added graphics, D8 input, and external power connector
    [cut down control board.csv, cut down control board.kicad_pcb, cut down control board.kicad_sch]
2022-10-13 final board 10/12/2022
    [cut down control board-B_Cu.gbr, cut down control board-B_Mask.gbr, cut down control board-B_Paste.gbr, cut down control board-B_Silkscreen.gbr, cut down control board-Edge_Cuts.gbr, cut down control board-F_Cu.gbr, cut down control board-F_Mask.gbr, cut down control board-F_Paste.gbr]
2022-10-13 update BOM
    [cut down control board.csv]
2022-10-14 annotated BOM with Mouser links
    [cut down control board BOM annotated.xlsx, cut down control board.kicad_pcb]
2022-10-15 flipped motor down
    [9939T314_Vibrate-Damping Precision Flexible Shaft Coupling.SLDPRT, Reel eyelet.SLDPRT, big motor body.SLDPRT, cut down control board.SLDASM, cut down control board.kicad_sch, enclosure.SLDPRT, left receiver plate.SLDPRT, right receiver plate.SLDPRT]
2022-10-16 updates to enclosure and mechanism
    [91770A548_Extra-Wide Truss Head Phillips Screws.SLDPRT, 91770A550_Extra-Wide Truss Head Phillips Screws.SLDPRT, 91772A205_Passivated 18-8 Stainless Steel Pan Head Phillips Screw.SLDPRT, 94459A413_Heat-Set Inserts for Plastic.SLDPRT, 94639A332_Off-White Nylon Unthreaded Spacer.SLDPRT, 94639A335_Off-White Nylon Unthreaded Spacer.SLDPRT, 94639A401_Off-White Nylon Unthreaded Spacer.SLDPRT, 94639A431_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]
2022-10-17 added mockup of rockblock and ultimate gps board
    [rockblock.SLDPRT, spool.SLDPRT, ultimate GPS.SLDPRT]
2022-10-17 add detail to GPS and Sat modem model
    [91772A081_Passivated 18-8 Stainless Steel Pan Head Phillips Screw.SLDPRT, 94639A469_Off-White Nylon Unthreaded Spacer.SLDPRT, 9939T314_Vibrate-Damping Precision Flexible Shaft Coupling.SLDPRT, Part3.SLDPRT, enclosure brace TOP.SLDPRT, enclosure_with_dome.SLDPRT, left receiver plate.SLDPRT, right receiver plate.SLDPRT]
2022-10-17 customized tube caps
    [9753K538_Round Caps.SLDPRT, 9753K538_Round Caps_with_oblong_hole.SLDPRT, enclosure brace TOP.SLDPRT, left receiver plate.SLDPRT, spool.SLDPRT]
2022-10-17 added switch and switch housing, longer quick-release pin
    [9753K538_Round Caps.SLDPRT, 98320A140_Zinc-Plated Steel Ring-Grip Quick-Release Pin.SLDPRT, 98404A959_18-8 Stainless Steel Ring-Grip Quick-Release Pin.SLDPRT, 98404A960_18-8 Stainless Steel Ring-Grip Quick-Release Pin.SLDPRT, MBZ1_xxxC02X02.SLDASM, MBZ1_xxxC02X02.stp, enclosure brace.SLDPRT, spool.SLDPRT]
2022-10-18 phoenix connector QD terminal block
    [9753K538_Round Caps.SLDPRT, 9753K538_Round Caps_with_oblong_hole.SLDPRT, 9939T314_Vibrate-Damping Precision Flexible Shaft Coupling.SLDPRT, enclosure brace TOP.SLDPRT, left receiver plate.SLDPRT, monofilament.SLDPRT, nichrome_3,5mm.SLDPRT, phoenix_2pos_horiz_pxc_1844210_05_MC-1-5-2-G-3-5_3D.SLDASM]
2022-10-19 reworked top of enclosure
    [94639A341_Off-White Nylon Unthreaded Spacer.SLDPRT, 94639A401_Off-White Nylon Unthreaded Spacer.SLDPRT, 9753K538_Round Caps.SLDPRT, 9753K538_Round Caps_with_oblong_hole.SLDPRT, 9939T314_Vibrate-Damping Precision Flexible Shaft Coupling.SLDPRT, enclosure brace BOTTOM.3mf, enclosure brace BOTTOM.SLDPRT, enclosure brace BOTTOM.STL]
2022-10-20 Update master assembly.SLDASM
2022-10-20 make spool STL and gcode
    [spool flange.STL, spool.STL]
2022-10-21 create rigging pog
    [rigging pog.SLDPRT, rigging pog.STL]
2022-10-24 added short parachute monofilament pigtail and loop in long balloon pigtail
    [9753K538_Round Caps_with_oblong_hole.SLDPRT, enclosure brace TOP.SLDPRT, monofilament pigtail.SLDPRT, monofilament.SLDPRT, spool.SLDPRT]
2022-10-24 redo changes
    [left receiver plate.SLDPRT, right receiver plate.SLDPRT, spool.SLDPRT]
2022-10-24 redo some changes
    [9753K538_Round Caps.SLDPRT, left receiver plate.SLDPRT, spool.SLDPRT]
2022-10-24 fix to master assembly mate
    [9753K538_Round Caps.SLDPRT]
2022-10-25 reversed picoblade connector for rockblock 9603
    cable pin 1 to pin 10, pin 2 to 9, etc (premade cables are reversed)
    [cut down control board.kicad_pcb, cut down control board.kicad_sch]
2022-10-25 update gerbers and drill files
    [cut down control board-B_Cu.gbr, cut down control board-B_Mask.gbr, cut down control board-B_Paste.gbr, cut down control board-B_Silkscreen.gbr, cut down control board-Edge_Cuts.gbr, cut down control board-F_Cu.gbr, cut down control board-F_Mask.gbr, cut down control board-F_Paste.gbr]
2022-10-26 firmware bugfix
    [8880K83_Easy-to-Form Nickel Chromium Alloy.SLDPRT]
2022-10-27 swapped gps rx/tx pins, modified blinks, compute voltage
    [ballooning_state_engine.ino, configure.py]
2022-10-28 explicitly select external analog reference voltage; improve serial debug output
2022-10-28 fix letdown_delay bug
    device was waiting letdown_delay seconds before "launching" then waiting another letdown_delay seconds before activating letdown motor.
    [ballooning_state_engine.ino]
2022-10-28 updates
    bug fix for firmware, comparison between uint32 and int32 (typecast)
    flip rockblock 9603, longer screws, longer spacers
    new rigging pog
    [91772A084_Passivated 18-8 Stainless Steel Pan Head Phillips Screw.SLDPRT, 94639A711_Off-White Nylon Unthreaded Spacer.SLDPRT, rigging pog 2.SLDPRT, rigging pog 2.STL, spacer_rockblock_for_3d.3mf, spacer_rockblock_for_3d.SLDPRT, spacer_rockblock_for_3d.STL]
2022-10-28 add hot wire cutter assembly holder
    [91772A084_Passivated 18-8 Stainless Steel Pan Head Phillips Screw.SLDPRT, 94639A711_Off-White Nylon Unthreaded Spacer.SLDPRT, 9753K538_Round Caps.SLDPRT, enclosure brace BOTTOM.SLDPRT, hot wire cutter assembly holder.SLDPRT, left receiver plate.SLDPRT, phoenix_2pos_terminal_blk_pxc_1840366_05_MC-1-5-2-ST-3-5_3D.SLDASM, right receiver plate.SLDPRT]
2022-10-28 new top enclosure brace w/ hot wire cutter assembly mount
    [9753K538_Round Caps.SLDPRT, enclosure brace BOTTOM.SLDPRT, enclosure brace TOP v2.SLDPRT, enclosure brace TOP v2.STL, hot wire cutter assembly holder.STL, hot wire cutter assembly mount.SLDPRT, left receiver plate.SLDPRT, nichrome_3,5mm.SLDPRT]
2022-10-28 remove rockblock sleep from schematic and pcb
    [cut down control board.kicad_pcb]
2022-10-28 modify receiver plates
    [cut down control board.kicad_sch, left receiver plate.3mf, left receiver plate.SLDPRT, left receiver plate.STL, right receiver plate.STL]
2022-10-29 set materials and appearances
    [91770A548_Extra-Wide Truss Head Phillips Screws.SLDPRT, 91772A205_Passivated 18-8 Stainless Steel Pan Head Phillips Screw.SLDPRT, 97171A160_Brass Heat-Set Inserts for Plastic.SLDPRT, 97171A230_Brass Heat-Set Inserts for Plastic.SLDPRT, 98404A960_18-8 Stainless Steel Ring-Grip Quick-Release Pin.SLDPRT, 9939T314_Vibrate-Damping Precision Flexible Shaft Coupling.SLDPRT, Copper tape.SLDPRT, big motor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]
2022-10-29 shorten motor test to 50ms
    [ballooning_state_engine.ino]
2022-10-29 add foam spacer to bottom
    [9753K538_Round Caps.SLDPRT, 9753K538_Round Caps_with_oblong_hole.SLDPRT, enclosure brace BOTTOM.SLDPRT, enclosure brace TOP v2.SLDPRT, foam spacer.SLDPRT, left receiver plate.SLDPRT, plastic tube.SLDPRT, spool.SLDPRT]
2022-10-29 tweak the top enclosure brace hot wire cutter holder
    [enclosure brace TOP v2.SLDPRT, enclosure brace TOP v2.STL]
2022-10-29 check for swapped min/max lat and lon, correct automagically
    [configure.py]
2022-10-30 fix ADC formula to get voltage
    [ballooning_state_engine.ino]
2022-10-30 add PDF of pcb and schematic as produced
    [cut down control board.kicad_sch]
2022-10-30 added decode function and more verbose output for programming device
2022-10-30 make dump_config function, search for CFG in device output
2022-10-30 LED pin name fixes, gps validity check attempt to fix, LED now interrupt driven
    [ballooning_state_engine.ino]
2022-10-31 move turn-on of interrupt driven blink to end of setup
2022-10-31 update switch housing on bottom enclosure brace
    [enclosure brace BOTTOM v2.STL, enclosure brace BOTTOM.SLDPRT, foam spacer.SLDPRT]
2022-10-31 fixed two bugs
    firmware: gps light stays on steady when valid & recent
    configure.py: convert hex ascii bytes to python bytes
    [ballooning_state_engine.ino, configure.py]
2022-10-31 read the BAD cfg after programming and print in readable form
2022-10-31 improve switch holder on enclosure brace bottom
    [enclosure brace BOTTOM.SLDPRT, foam spacer.SLDPRT]
2022-11-02 Fix mike config to let down after power on
    [configure.py]
2022-11-03 added checkcfg to dump the current configuration
2022-11-03 update top enclosure brace to smiley face
    [Copper tape.SLDPRT, enclosure brace TOP v3.SLDPRT, enclosure brace TOP v3.STL]
2022-11-03 init pressure sensor before sat modem
2022-11-03 fix typo
    [9753K538_Round Caps.SLDPRT, foam spacer.SLDPRT]
2022-11-03 add wire lengths in schematic
    [cut down control board.kicad_sch]
2022-11-03 added top enclosure brace artwork
    [enclosure brace TOP v3.SLDPRT]
2022-11-03 fix CFG bug
    CFG memcpy was in wrong direction, so corrupted config structure
    need to copy FROM config, TO MO_buffer
    tested and works now
    [enclosure brace TOP v3.STL]
2022-11-04 improve hot wire cutter holder
    [enclosure brace TOP v3.SLDPRT, enclosure brace TOP v3.STL]
2022-11-05 Update smiley face
    [enclosure brace TOP v3.SLDPRT, enclosure brace TOP v3.STL]
2022-11-05 update all STL files
    [enclosure brace BOTTOM v2.STL, enclosure brace BOTTOM.3mf, enclosure brace BOTTOM.SLDPRT, enclosure brace BOTTOM.STL, enclosure brace TOP v2.STL, enclosure brace TOP.3mf, enclosure brace TOP.STL, hot wire cutter assembly holder.STL]
2022-11-07 tweak enclosure top
    [enclosure brace TOP v3.SLDPRT]
2022-11-07 update top enclosure brace STL file
    [enclosure brace TOP v3.STL]
2022-11-07 make device report IMEI on boot (in DEBUG mode)
2022-11-07 tweak top brace
    [enclosure brace TOP v3.SLDPRT]
2022-11-07 move cutter back inside device
    [9753K538_Round Caps.SLDPRT, 9753K538_Round Caps_with_oblong_hole.SLDPRT, 9939T314_Vibrate-Damping Precision Flexible Shaft Coupling.SLDPRT, enclosure brace TOP v4.STL, enclosure brace TOP.SLDPRT, left receiver plate.SLDPRT, monofilament pigtail.SLDPRT, nichrome_3,5mm.SLDPRT]
2022-11-09 monkey with top brace and delete old files
    [enclosure brace TOP v3.SLDPRT, enclosure brace TOP v3.STL, enclosure brace TOP v4.STL, enclosure brace TOP.SLDPRT, enclosure brace TOP.STL]
2022-11-09 update manual
    [9753K538_Round Caps_with_oblong_hole.SLDPRT, enclosure brace TOP.SLDPRT, monofilament pigtail.SLDPRT, spool.SLDPRT]
2022-11-10 check battery voltage before self-test
2022-11-11 fix CFG bug in firmware (responded to malformed, overlength packets)
    [ballooning_state_engine.ino, configure.py]
2022-11-11 fix let-down command and update configure.py to work around CFG buffer bug
    [ballooning_state_engine.ino, configure.py]
2022-11-12 rename spool -> spool axle to differentiate from spool flange
    [spool axle.SLDPRT, spool.SLDPRT]
2022-11-14 added code to change after CFG fix applied to all devices
    [ballooning_state_engine.ino]
2022-11-16 cut debugging messages
    added cutXX and letXX commands, fixed some if/then/else logic in process_cmd, moved some stuff into process_cmd that was in main loop(), changed default unprogrammed config, added debug message for various cut conditions
    [ballooning_state_engine.ino, configure.py, decode.py]
2022-11-16 added additional states for cause of cut-down (manual, time, pressure, geofence, dist)
2022-11-17 LET command in serial setup mode fix
    [ballooning_state_engine.ino]
2022-11-17 redo satellite communication message handling & fix boot up motor/cutter test
    [ballooning_state_engine.h, ballooning_state_engine.ino]
2022-11-24 motor stall detect added + refactor code
    [ballooning_state_engine.ino]
2022-11-26 tweak battery/circuit test sequence
2022-11-26 add sos flash to indicate pressure sensor error
    [ballooning_state_engine.ino]
2022-11-26 added rigging bulkhead assembly
    [bulkhead assembly.SLDASM, bulkhead body.SLDPRT, bulkhead nut.SLDPRT, enclosure brace TOP.SLDPRT, spool axle.SLDPRT]
2022-11-26 adjust dimensions of foam slot
    [bulkhead body.SLDPRT]
2022-11-27 created STL files
    [bulkhead body BOTTOM.STL, bulkhead body TOP.STL, bulkhead body.SLDPRT, bulkhead nut.STL]
2022-11-27 create bulkhead prusa project
    [bulkhead assembly.SLDASM, bulkhead body.SLDPRT, bulkhead.3mf]
2022-11-28 tweak nut dimensions
    [bulkhead assembly.SLDASM, bulkhead nut.SLDPRT, bulkhead nut.STL, bulkhead.3mf]
2022-11-28 add small bottom bulkhead for letdown line
    [8694K141_Light Duty Blended EPDM Foam Strip.SLDPRT, 93565K118_Super-Cushioning Polyethylene Foam Strip.SLDPRT, 9753K538_Round Caps.SLDPRT, bulkhead assembly small.SLDASM, bulkhead assembly.SLDASM, bulkhead body BOTTOM.STL, bulkhead body TOP.STL, bulkhead body small BOTTOM.STL]
2022-11-28 dimension tweaks and new STL
    [bulkhead assembly.SLDASM, bulkhead body BOTTOM.STL, bulkhead body TOP.STL, bulkhead body.SLDPRT, bulkhead nut.SLDPRT, bulkhead nut.STL]
2022-11-29 more tweaks to small bulkhead
    [bulkhead body TOP.STL, bulkhead body small BOTTOM.STL, bulkhead body small TOP.STL, bulkhead body small.SLDPRT, bulkhead nut small.SLDPRT, bulkhead nut small.STL, bulkhead small 040mm.3mf]
2023-01-06 embiggen spool
    [bulkhead assembly small.SLDASM, bulkhead body small.SLDPRT, enclosure brace TOP.SLDPRT, left receiver plate.SLDPRT, spool axle LARGE.SLDPRT, spool axle LARGE.STL, spool flange LARGE.SLDPRT, spool flange LARGE.STL]
2023-01-09 add reinforcement ridge to edge of spool
    [spool axle LARGE.SLDPRT, spool axle LARGE.STL, spool flange LARGE.SLDPRT, spool flange LARGE.STL]
2023-01-17 large spool tweak
    [9939T314_Vibrate-Damping Precision Flexible Shaft Coupling.SLDPRT, enclosure brace BOTTOM 2 hole.SLDPRT, enclosure brace BOTTOM 2 hole.STL, enclosure brace BOTTOM.SLDPRT, enclosure brace TOP.SLDPRT, spool axle LARGE.SLDPRT, spool axle LARGE.STL, spool flange LARGE.SLDPRT]
2023-01-17 bumped motor voltage drop threshold for detection
2023-01-19 spool axle; more clearance between plates
    [spool axle LARGE.SLDPRT, spool axle LARGE.STL]
2023-01-19 loosen threshold for overcurrent
    [ballooning_state_engine.ino]
